kira11-hash/snn-soc/README.md

# SNN SoC 工程

本仓库提供一个**数模混合 SNN SoC**，当前为 MVP 版本，目标迭代到 V1 版本流片（数字单独流片 + 片外混合集成验证），后续再进行片上混合集成。

## 项目目标

| 版本 | 状态 | 说明 |
| :--- | :----: | :--- |
| **MVP** |  ✅ 完成  | 基础功能可仿真跑通 |
| **V1 RTL** | ✅ 功能冻结 | E203 + UART + SPI + DMA多目标 + AXI-Lite bridge + JTAG rescue 全部接入，仿真全量通过 |
| **V1 TO** | 🚧 进行中 | 综合 / PPA / 后端 P&R / DFT / STA 签核 / pad cell 集成 / ROM handoff |

**流片目标**：2026年6月30日，数字 SoC 单独流片 + 片外混合集成验证（数字 SoC + 模拟 CIM Macro）
**时钟频率**：50MHz（目标）

## MVP 功能
- 支持寄存器配置阈值与推理帧数（TIMESTEPS）
- DMA 从 data_sram 搬运 bit-plane 输入到 input_fifo
- CIM 控制器按 帧 × PIXEL_BITS 子时间步循环 DAC/CIM/ADC
- ADC 时分复用 20 路（Scheme B：10 正 + 10 负），`neuron_in_valid` 对应一次完整扫描后的 10 路差分结果
- LIF 在有效拍按 bitplane_shift 左移累加并产生 spike 写入 output_fifo
- Testbench 自动跑完整流程，并按仿真器生成 FSDB 或 VCD 波形

## 快速开始（VCS + Verdi）
> Linux / WSL 原生环境可直接使用 bash。Windows 本机回归建议优先使用 Git Bash；WSL 在本仓库里主要用于 `run_e203_icarus.sh` / `run_jtag_rescue_top_icarus.sh` 的 RISC-V 固件构建链路。

1) 编译并仿真（生成 FSDB）
```
./sim/run_vcs.sh
```

2) 打开 Verdi
```
./sim/run_verdi.sh
```

### 环境变量要求
- `VERDI_HOME`：指向 Verdi 安装目录（用于 FSDB PLI）。
- 若平台版本不同，可在 `sim/run_vcs.sh` 中调整 PLI 路径。
- Windows 下请优先使用 Git for Windows 自带的 `bash.exe` / `sh.exe` 运行 `sim/*.sh`；不要直接用 `C:\Windows\System32\bash.exe`（WSL bash），否则可能找不到本机安装的 `iverilog` / `verilator`。
- 若在 PowerShell 中先执行 `Get-Command bash` 发现命中的是 `C:\Windows\System32\bash.exe`，说明当前 `bash` 实际指向 WSL，而不是 Git Bash；此时普通 Icarus / shell 语法门禁请显式调用 Git Bash（常见路径：`C:\Program Files\Git\bin\bash.exe`），只有 `run_e203_icarus.sh` / `run_jtag_rescue_top_icarus.sh` 这类需要交叉编译固件的脚本才会在内部再转去 WSL。
- 若在 `bash`/WSL 中看到 `$'\r': command not found`，说明本地 checkout 把 `.sh` 脚本变成了 CRLF；仓库期望 `*.sh` 为 LF（见 `.gitattributes`），请先按 LF 重新检出后再运行。
- 带权重的 Icarus/VCS 流程依赖外部生成的 `weight_pos.hex` / `weight_neg.hex`；仓库默认不提交这些导出物，可放在任意 `results/exports/` 目录、`fpga/cim_model/` 或 `sim/` 下；如需显式指定来源，可设置 `WEIGHT_SRC_DIR=<目录>`。
- `run_sample_align.sh` 额外依赖 `all_samples.hex` / `expected_classes.hex`；脚本会在仓库内自动查找 `rtl_stimulus/` 目录，也可通过 `STIMULUS_DIR=<目录>` 强制指定。
- 若在 Windows PowerShell 里直接跑 `chip_top` 门禁，请使用 `iverilog.exe` / `verilator.cmd`；不要把 `iverilog` / `verilator` 包在 `bash -lc "..."` 里，否则可能误走到 WSL 环境中的错误 PATH。
- `run_e203_icarus.sh` / `run_jtag_rescue_top_icarus.sh` 会在运行时临时创建 `rtl/vendor_e203` junction，把仓库内 `e203_hbirdv2-master/rtl` 映射到纯 ASCII 路径后再编译；这是为了规避 Windows + Icarus 对 vendor 路径/非 ASCII 路径的读取问题。脚本退出时会自动清理该 junction，因此不要把 `sim_e203.f` / `sim_jtag_rescue_top.f` 视为完全脱离脚本即可裸跑的 filelist。

## 常用回归入口
> Windows 日常回归建议用 Git Bash；`run_e203_icarus.sh` 额外依赖 WSL 中可用的 `riscv64-unknown-elf-gcc / objcopy`。
> `run_e203_icarus.sh` / `run_jtag_rescue_top_icarus.sh` 会在构建固件时临时覆盖 `UART_BAUD_DIV=2` 以缩短 Icarus 仿真时间；`uart_ctrl` 的默认硬件口径仍是 `434`（50MHz / 115200）。

- `cd sim && bash run_uart_icarus.sh`：UART 单测，期望 `UART_SMOKETEST_PASS`
- `cd sim && bash run_spi_icarus.sh`：SPI 单测，期望 `SPI_SMOKETEST_PASS`
- `cd sim && bash run_dma_icarus.sh`：DMA 单测，期望 `DMA_SMOKETEST_PASS`
- `cd sim && bash run_axi_bridge_icarus.sh`：AXI-Lite bridge 单测，期望 `AXI_BRIDGE_SMOKETEST_PASS`
- `cd sim && bash run_icarus_light.sh`：黑盒顶层 smoke，期望 `LIGHT_SMOKETEST_PASS`
- `cd sim && bash run_icarus_weighted.sh +FAIL_ON_ZERO_SPIKE=1`：带权重顶层回归，期望 `WEIGHTED_SIM_PASS`
- `cd sim && bash run_sample_align.sh`：Python↔RTL 100 样本对齐，期望 `SAMPLE_ALIGN_PASS`
- `cd sim && bash run_adc_sat_counter.sh`：ADC 饱和计数回归，期望 `ADC_SAT_COUNTER_PASS`
- `cd sim && bash run_jtag_loader_icarus.sh`：JTAG rescue loader 单测，期望 `JTAG_MEM_LOADER_PASS`
- `cd sim && bash run_jtag_pyhost_selftest.sh`：Python 主机侧无硬件自测，期望 `JTAG_PYHOST_SELFTEST_PASS`
- `cd sim && bash run_jtag_rescue_top_icarus.sh`：JTAG rescue 顶层回归，期望 `JTAG_RESCUE_TOP_PASS`
- `cd sim && bash run_e203_icarus.sh`：E203 最小启动链回归，期望 `E203_SMOKETEST_PASS`
- `cd sim && bash run_silicon_bringup.sh`：数字 die 自检固件回归，期望 `SILICON_BRINGUP_TB_PASS`
- `cd sim && bash run_prog_bypass_latch.sh`：验证 `PROG_CTRL.START` busy 期间重写不会破坏 in-flight bypass，期望 `PROG_BYPASS_LATCH_TB_PASS`
- `cd sim && bash run_chip_top_rom_smoke.sh`：`chip_top` + `ENABLE_BOOT_ROM=1` + SPI boot smoke，期望 `CHIP_TOP_ROM_SMOKE_PASS`
- `cd sim && iverilog -g2012 -gno-assertions -f rtl_with_chip_top_check.f -s chip_top -o chip_top_check.out`：TO 路径的 `chip_top` 编译门禁
- `verilator.cmd -Wall --lint-only --top-module chip_top -Wno-DECLFILENAME -Wno-UNUSEDSIGNAL -Wno-UNUSEDPARAM -Wno-PINCONNECTEMPTY -Wno-CASEINCOMPLETE -f sim\\rtl_with_chip_top_check.f`：`chip_top` lint 门禁
- `python scripts/check_markdown_links.py`：检查所有 Git 跟踪 `.md` 文件的本地相对链接是否存在

2026-03-31 实跑复核结论：上述 UART/SPI/DMA/AXI-Lite bridge/light smoke/weighted/sample-align/ADC/JTAG loader/JTAG rescue top/E203、`chip_top` 编译/lint、旧 `top_tb` 入口、shell/python 语法门禁，以及 Markdown 本地链接门禁已在当前 `main` 重新执行通过。

完整的 2026-03-31 全量复核覆盖面、通过口径，以及 `chip_top` 编译/lint、旧 `top_tb` 入口和脚本语法门禁说明见 `doc/09_smoke_test_checklist.md`。

## 目录结构
```
rtl/   RTL 实现
  top/      顶层与参数包
  bus/      简化总线与地址译码
  mem/      SRAM + FIFO
  reg/      reg bank + fifo 状态窗
  dma/      DMA 引擎
  snn/      CIM 控制器 + DAC/ADC + LIF + Macro 行为模型
  periph/   UART/SPI 外设 + Rescue JTAG loader

tb/    Testbench
sim/   仿真脚本与波形
scripts/ Python 主机工具
doc/   中文说明文档
```

## V1.1 / Tape-out Prep 增量

- `boot_rom` 已接入主线地址图：
  - `chip_top` 路径下 `BOOT_ROM @ 0x0000_0000..0x0000_0FFF`
  - `INSTR_SRAM @ 0x0000_1000..0x0000_4FFF`
- `fw/boot_rom/boot_rom_main.c`：Mask ROM 里的 SPI bootloader
- `fw/link_app.ld`：应用固件链接到 `0x0000_1000`
- `scripts/make_boot_image.py`：生成带 16-byte `'BOOT'` header 的 SPI flash image
- `tb/chip_top_tb.sv` / `run_chip_top_rom_smoke.sh`：ROM boot 综合级 smoke 已打通
- `fw/silicon_bringup/silicon_bringup.c`：数字 die 自检固件（`test_mode + BYPASS_HANDSHAKE`）

这意味着当前 `main` 已经同时具备：

1. **V1 默认 Gate A 回归口径**（`ENABLE_BOOT_ROM=0`）
2. **Tape-out 目标 boot 口径**（`chip_top.ENABLE_BOOT_ROM=1`）
3. **Day 1 / Day 2 silicon bring-up 基础设施**

## 关键说明
- **参数口径**：所有默认参数与时序常量以 `rtl/top/snn_soc_pkg.sv` 为准，文档中的数值仅作说明与示例，若不一致请以 pkg 为准。
- 当前工程冻结的 RTL / bring-up 参数：`NUM_INPUTS=64`、`ADC_BITS=8`、`PIXEL_BITS=8`、`ADC_CHANNELS=20`、`T=10`、`ratio_code=1`、`THRESHOLD_DEFAULT=2550`、`NEURON_DATA_WIDTH=9`、`reset_mode=soft`，默认离线压缩/预处理口径为 `avgpool8x8`。
- `W=4`（4-bit 量化权重）仅属于 Python 训练/量化实验口径，用于解释建模结果中的权重精度；它**不是** RTL 冻结参数，`rtl/top/snn_soc_pkg.sv` 中无此定义。
- 输入编码：当前默认离线压缩/预处理口径为 `avgpool8x8`，得到 8x8=64 维特征（NUM_INPUTS=64）、每维 8bit；RTL 仅冻结 64x8 接口，不在硬件中固化前处理算法。同一子时间步并行送 64 维特征的第 x 位，顺序为 MSB->LSB。
- data_sram 排布：每个 bit-plane 为 64-bit，按 2 个 32-bit word 保存（word0=低32位，word1=高32位）。
- TIMESTEPS 表示帧数；总子时间步 = TIMESTEPS × PIXEL_BITS。
- 当 TIMESTEPS=0 时，推理立即结束。
- LIF 位宽建议：`LIF_MEM_WIDTH >= NEURON_DATA_WIDTH + PIXEL_BITS`。
- 默认阈值为 `THRESHOLD_DEFAULT`（工程默认计算：`THRESHOLD_RATIO_DEFAULT × (2^PIXEL_BITS - 1) × TIMESTEPS_DEFAULT = 1 × 255 × 10 = 2550`，可软件覆盖）。
- CIM Macro 在仿真中为行为模型，综合时为黑盒，可替换真实宏。
- UART 已实现最小 TX 路径（RX 仍为 V1 预留），SPI 已实现 Mode 0 主控，JTAG 已切换为独立 rescue loader：仅开放 `instr_sram / data_sram / weight_sram` 访问与 CPU 局部重启。
- tapeout 前全量回归的建议检查面与逐项操作说明见 `doc/09_smoke_test_checklist.md`。

## 建模定版补充（复位模式，2026-02-10）
- 对比对象：`SPIKE_RESET_MODE=soft` vs `SPIKE_RESET_MODE=hard`；当前 RTL 默认 `reset_mode=soft`，其余建模参数以各次对比实验冻结配置为准。
- 当前工程默认 `T=10`；如需做精度/时延 trade-off，可额外比较更小的 `T`。
- 对比入口：`run_all.py` 的 `[3f]`（噪声影响，`add_noise=True`）和 `[3l]`（test 多 seed noisy，`add_noise=True`）。
- soft（历史基线）：
  - val noisy mean：`90.41% +/- 0.0031`
  - test noisy（multi-seed）：`90.98% +/- 0.0012`
- hard（2026-02-10 复跑）：
  - val noisy mean：`90.51% +/- 0.0034`
  - test noisy（multi-seed）：`90.98% +/- 0.0012`
- 结论：
  - 当前推荐配置下，soft/hard 在 noisy test 指标上等效（数值一致）。
  - val 侧 `0.10%` 差异小于统计波动量级（`~0.31%-0.34%`），不具显著性。
  - V1 参数继续沿用 `soft`，理由是与既有 RTL/文档口径一致，且无需引入额外改动风险。
- 结果证据：
  - `项目相关文件/器件对齐/Python建模/summary.txt`
  - `项目相关文件/器件对齐/Python建模/results/run_all_skiptrain_hard_20260210_161450.log`

## 文档索引

### 正式文档（推荐阅读）

| 文件 | 内容 |
|---|---|
| `doc/00_overview.md` | 工程总览、当前状态与验证结论 |
| `doc/01_memory_map.md` | 地址映射（SRAM 窗口 + MMIO 分区） |
| `doc/02_reg_map.md` | **寄存器完整说明（权威真源）** |
| `doc/03_cim_if_protocol.md` | CIM 内部接口协议（信号 + 时序） |
| `doc/04_walkthrough.md` | 一次完整推理流程详解 |
| `doc/05_debug_guide.md` | 调试/救援指南（JTAG、常见问题） |
| `doc/06_learning_path.md` | **新手必读学习路径** |
| `doc/07_tapeout_schedule.md` | 流片路线图（主体为历史计划，以文末 Status Sync 为当前状态） |
| `doc/08_cim_analog_interface.md` | 数模接口规格（双芯片 PCB 集成，对外发送权威版本） |
| `doc/09_smoke_test_checklist.md` | **全量仿真操作手册（含命令、预期输出、故障排查）** |
| `doc/10_server_proxy_guide.md` | 校园网服务器代理/VPN 配置 |
| `doc/11_analog_handoff_execution_plan.md` | 数字→模拟接口对接文档（参数已冻结，供模拟团队参考） |
| `doc/12_fpga_validation_guide.md` | FPGA 系统验证指南 |
| `doc/13_fpga_paper_plan.md` | FPGA 验证平台方案 |
| `doc/14_gemm_accelerator_plan.md` | 双模态 AI SoC（GEMM+SNN）扩展规划（V2/V3 远景） |
| `doc/15_asic_pad_map.md` | **ASIC Pad Map（55 pad 冻结真源）** |
| `doc/17_cim_macro_handoff_cover.md` | **发给模拟 CIM macro 同学的封面说明（先读这份）** |
| `doc/16_iteration_log.md` | 迭代变更日志（Phase 4 全外设接入记录） |
<!--
DOC-B3 fix（2026-05-02 audit）：原 4 份 IC 论文 prompt 模板（17/18/19/20）
已从 `eassy-prompt/` 删除（且整目录在 .gitignore 中忽略），保留这 4 行索引
会让读者按图索骥找不到文件。如未来恢复，需要：
  (a) 把 `eassy-prompt/` 从 .gitignore 移出
  (b) 重建这 4 份 prompt 文件
  (c) 重新追加索引
当前 `eassy-prompt/` 仅保留 2 份 GPT review 历史 prompt
（gpt_review_2026-04-22 / gpt_review_2026-04-24），是 audit 工作日志，
不属对外文档索引。
-->

### 草稿文档（已整合到正式文档）
- 早期 `develop docs` 草稿目录已从仓库移除，相关内容已整合到上述 `doc/*.md` 正式文档中；如需追溯演进过程，请查看 Git 历史。

## 片外/片上混合集成说明

本项目将分阶段完成数模集成：
- 数字部分：本项目的 RTL（SoC 控制器、DMA、LIF 神经元等）
- 模拟部分：真实 CIM Macro（由其他同学提供版图）
- V1：数字 SoC 单独流片，片外与模拟宏连接验证
- V2/V3：片上数模混合集成
- 接口约定：`cim_macro_blackbox.sv` 的端口定义保持不变
- 时钟频率：目标 50MHz（数模混合需要保守时序裕量）

### 论文写作口径备忘（V1 vs V2）

- 当前 `V1` 的真实形态是**双芯片 PCB 集成**：数字 SoC 与模拟 `CIM Macro` 独立流片、独立封装，通过 `wl_data / bl_sel / bl_data / cim_start / cim_done` 等 pad 信号互联。
- 当前已经冻结的是**外部推理接口**；若 `V1` 还要求外部模拟 die 支持数字发起 `erase/write/verify`，则仍需先冻结跨芯片编程合同。参见 `doc/17_cim_macro_handoff_cover.md` 与 `doc/11_analog_handoff_execution_plan.md` A8。
- 因此，当前版本**不能**写成“已实现片上数模混合集成”或“已解决互联问题”；更准确的说法是：本工作完成了面向混合集成的数字 SoC，并验证了其与外部 `CIM Macro` 协同工作的控制逻辑、接口协议和推理链路。
- 面向后续 `V2/V3`，可以将“单芯片数模混合集成以降低片间通信延迟、接口能耗与数据搬运开销”写成 roadmap / motivation，但必须明确这是未来工作，而非 `V1` 已实现事实。
- 若后续实现同一颗 die 上的数模混合集成，则可强调“控制器与 `CIM Macro` 的片上紧耦合”带来的系统级收益；若仅做到同封装 `MCM/SiP`，则应表述为“封装级集成”，不等同于单 die 片上集成。

> 推荐备用句式：本工作完成了完整数字 SoC 的设计与 RTL 级验证，并确认了其与外部 `CIM Macro` 协同工作的控制逻辑、接口协议和推理链路；当前 `V1` 采用双芯片 PCB 集成，后续 `V2/V3` 将进一步推进单芯片数模混合集成，以降低片间通信开销并实现更紧耦合的系统级协同。
