kira11-hash/snn-soc/项目相关文件/SNN SoC的读书笔记/ANP-I.md

这篇论文来自**清华大学（陈弘教授团队）**，发表在 **JSSC 2024**（这是集成电路设计领域的顶级期刊）。

它的核心关键词是**“异步逻辑（Asynchronous）”**和**“在线学习”**。虽然你的 V1 版本是同步电路设计，但这篇论文关于**如何通过数字逻辑“偷懒”（跳过无效计算）**的设计思路，对 SoC 性能优化极具参考价值。

---

### 【论文名称】
**ANP-I: A 28-nm 1.5-pJ/SOP Asynchronous Spiking Neural Network Processor Enabling Sub-0.1-µJ/Sample On-Chip Learning for Edge-AI Applications**

**1) SoC 相关核心内容（只写 3–5 条）**
*   **全异步数字架构：** 抛弃了全局时钟，利用“握手协议（Handshake）”驱动数据流。只有在有脉冲时电路才会翻转，没脉冲时完全静默。
*   **随机目标窗口（TW）：** 为了在线学习，不需要存入样本的所有脉冲，而是只抓取一小段“窗口”内的脉冲存入 Buffer。这极大减小了 SoC 内部存储器的面积需求。
*   **分级更新跳过（HUS）：** 在芯片级、内核级、突触级三层设置了“跳过检查”。如果某个区域没有脉冲，直接切断控制路径，不产生访存动作。
*   **异步时间步加速（ATSA）：** 不需要等待固定的时钟周期，一旦当前计算任务完成，硬件立刻“握手”进入下一个时间步，消除了 SoC 的空转等待时间。

**2) 论文里暴露的系统级痛点**
*   **痛点 1：学习能效开销巨大。** 传统 SoC 在做在线学习（BP 算法类似物）时，能耗通常是推理的数倍，导致移动设备无法长时间在线进化。
*   **痛点 2：空闲功耗（Idle Power）。** 在同步 SoC 中，即使没有神经元在发放，时钟网络依然在不断翻转消耗电能。
*   **痛点 3：存储墙问题。** 记录神经元历史脉冲轨迹（用于计算权重更新）需要占用大量片上 SRAM，限制了 SoC 支持的规模。

**3) 可转化为 SoC 数字创新点（3–5 条）**
*   **创新点 1（针对痛点 1 & 3）：脉冲缓冲窗口逻辑（Windowing Buffer）。** 
    *   在 E203 的 DMA 搬运路径上加一个计数器。只在计数器对应的特定区间（窗口）内将计算结果写回 L1 SRAM，其余时间不写。**（✅ 适合 V1：逻辑简单，能省 SRAM 访问能耗）**
*   **创新点 2（针对痛点 2）：层级使能门控（Hierarchical Gating）。** 
    *   设计一个“活动检测器”。当输入脉冲 FIFO 为空时，控制器不仅关闭计算，还通过分级使能信号关闭 CIM Macro 的外围接口电路。**（✅ 适合 V1：作为 SoC 的低功耗卖点）**
*   **创新点 3（针对延迟）：自适应 Done 信号反馈（Non-fixed Timer）。** 
    *   不要用固定的 Counter 来数周期。让 CIM 控制器根据任务量生成一个 `Task_Done` 信号给 E203。E203 收到后立刻切换下一层。这种“准异步”思想能显著提升 SoC 吞吐率。**（✅ 适合 V1：低风险高性能优化）**

**4) 是否适合短期实现（判断）**
*   ✅ **适合 V1（低风险）：** 
    *   **分级跳过逻辑（HUS）的简化版**：检测输入脉冲，为零则不触发 CIM 使能。
    *   **自适应 Done 信号控制流**：这是提高系统效率最快的方法。
*   ⚠️ **适合 V2/V3（高风险）：** 
    *   **全异步逻辑（Self-timed Click Controller）**：异步设计缺乏商业 EDA 工具支持，研一新生 V1 绝对不要碰，风险极高。
    *   **在线学习（S-TP 算法）**：V1 建议专注推理。

**5) 一句总结**
**这篇论文对你的价值在于：它教你如何通过“层层设卡”（HUS 逻辑）和“只管重点”（TW 窗口），在数字层面压榨出极致的稀疏性能效。**

---

### 💡 助手给你的 V1 选点建议：

目前你手里有五篇顶级论文了，如果你要在 **6/30 的 V1 版**中选创新点，我最推荐以下组合：

1.  **分级控制器（来自 SENECA）**：让 E203 当指挥官，自己写个 **Loop Buffer** 跑微指令，这是最稳且最像 SoC 的结构。
2.  **两级断电/使能管理（来自 ISSCC-2023 & ANP-I）**：只要没计算任务，就关掉接口。代码量小，但数据（功耗）对比会非常好看。
3.  **Ping-Pong FIFO 与 Shadow Register（来自 DIANA）**：保证你的 CIM 不要停下来等数据。

**你想针对哪一个创新点的具体 Verilog 实现逻辑进行深入探讨？**

ANP‑I 的核心是**异步逻辑 + 在线学习**，这两点对你 V1（同步、推理为主）**不合适**。  
但它有一些“思想层”的点可以借鉴成**同步系统里的轻量优化**：

**✅ V1 可以借鉴的（同步可做）**

1. **活动检测 + 计算跳过**
    
    - 当输入 FIFO 为空、或某个 bit‑plane 全 0 时，**不触发 CIM/ADC/LIF**。
    - 这其实是“同步版 HUS（跳过无效计算）”。
2. **层级使能门控（简化版）**
    
    - 不是异步电路，只是同步下的 enable/clock-enable。
    - 空闲时关闭 CIM/ADC/LIF 的时钟或使能，节能好讲故事。
3. **任务完成即 done（自适应 done）**
    
    - 不固定数周期，而是“任务跑完就 done”，你现在 FSM 基本就是这个思路。

**❌ V1 不建议碰**

- **全异步握手机制（handshake / self‑timed）**
- **在线学习/窗口记录机制**

**一句话结论**  
ANP‑I 适合当“论文动机来源”，V1 只吸收“跳过无效计算 + 空闲门控”这种轻量思想，**不要做异步逻辑**。

如果你要选一个 V1 落地的点，我建议：  
**“输入活动检测 → 自动跳过 CIM/ADC 并拉低 enable”**  
这块最稳、成本低，还能作为功耗亮点写进论文。
