kira11-hash/snn-soc/项目相关文件/SNN SoC的读书笔记/DIANA An End-to-End Hybrid DIgital and ANAlog Neural Network SoC for the Edge.md

这篇论文是来自 **KU Leuven（鲁汶大学）** 团队在 JSSC 2023 上发表的 **DIANA**。它是数模混合 SoC 的标杆作品，非常适合你用来构思 V1 版本的系统架构，因为它清晰地展示了如何用一个 RISC-V 控制一个“模拟黑盒”和一个“数字黑盒”。

【论文名称】
**DIANA: An End-to-End Hybrid DIgital and ANAlog Neural Network SoC for the Edge**

### 1) SoC 相关核心内容（只写 3–5 条）
*   **异构多核架构：** 整个 SoC 由一个 RISC-V 核心（PULPissimo 架构）、一个模拟 CIM 加速器（AIMC）和一个数字加速器（Digital Core）组成。
*   **三级存储体系：** 采用 L2 (512KB) -> L1 (256KB) -> L0 (寄存器) 的层次。L1 SRAM 被模拟和数字两个内核共享，作为它们之间的数据交换站（Communication Buffer）。
*   **专用存储控制器（MCU）：** 为 CIM 宏设计了专门的地址产生逻辑（Address Generator），支持卷积的滑动窗口、步长（Stride）和填充（Padding），不需要 CPU 干预地址计算。
*   **后处理流水线（SIMD）：** 在 CIM 宏的 ADC 输出后，紧跟了一个数字 SIMD 单元，专门负责 BatchNorm、ReLU、池化和量化，将模拟结果转回数字脉冲/数据。

### 2) 论文里暴露的系统级痛点
*   **痛点 1：权重搬运瓶颈。** 模拟 CIM 阵列虽然算得快，但“写权重”极慢。当网络层数很多且阵列放不下所有权重时，频繁从片外加载权重会导致计算单元严重空转。
*   **痛点 2：数据格式不匹配（Layout Mismatch）。** 模拟核喜欢按通道（Channel）并行，数字核喜欢按输出像素（OX）并行，导致数据在两个核之间传递时，必须进行耗时的“数据重组（Reshuffling）”。
*   **痛点 3：L1 缓存管理复杂。** 256KB 的 L1 需要被 CPU、DMA、模拟核、数字核四个角色同时竞争访问，如果仲裁（Arbitration）逻辑设计不好，会造成严重的流水线气泡。

### 3) 可转化为 SoC 数字创新点（3–5 条）
*   **创新点 1（针对痛点 3）：多行/多银行共享 L1 SRAM 仲裁器。** 设计一个支持高带宽、多端口的 L1 控制器，让 E203 在读取指令的同时，DMA 能够无冲突地把数据喂给 CIM Macro。**（V1 推荐：提升系统稳定性）**
*   **创新点 2（针对痛点 2）：硬件重组 DMA（Reshuffling DMA）。** 在 DMA 搬运过程中增加一个简单的硬件转置逻辑，数据从 CIM 出来进入 L1 时自动完成格式转换，消灭 CPU 整理数据的时间。**（V2 推荐：体现系统效率）**
*   **创新点 3（针对痛点 1）：预取控制器（Prefetching Controller）。** 利用影子寄存器，在 CIM 计算当前层时，控制器自动计算并触发 DMA 从 L2 提取下一层的权重到缓存。**（V1/V2 推荐：解释性强）**
*   **创新点 4（系统级）：端到端流水线（Layer Fusion）。** 设计硬件同步信号（Done/TRG 手柄），实现“层融合”：模拟核算完一小块数据，立刻触发数字核进行激活，不需要 CPU 频繁中断。

### 4) 是否适合短期实现（判断）
*   ✅ **适合 V1（低风险）：** 
    *   **L1 共享机制：** 用总线矩阵把 E203 和 CIM 连接到同一块 SRAM。
    *   **基础 FSM 控制器：** 代替 CPU 发送控制信号（如 `start_compute`, `read_adc`）。
*   ⚠️ **适合 V2/V3（高风险）：** 
    *   **硬件重组逻辑：** 涉及复杂的地址映射切换。
    *   **多核并行流水线：** 调试难度大，容易产生死锁（Deadlock）。

### 5) 一句总结
**DIANA 告诉我们：SoC 设计的关键不在于 CIM 阵列怎么画，而在于如何通过“多级缓存”和“硬件 FSM”让 CIM 阵列永远有数可算，不让 CPU 成为指挥瓶颈。**
✅ **V1 不需要再从 DIANA 加新功能**  
✅ 你最多只需要“借鉴它的理念作为论文对比点”
