kira11-hash/snn-soc/项目相关文件/SNN SoC的读书笔记/rram-sram-hybrid-target-tracking.md

这篇论文来自 **Georgia Tech（佐治亚理工）Arijit Raychowdhury** 教授团队，发表于 **ISSCC 2023**。它是一个非常典型的“数模混合异构系统”，最值得你借鉴的是它如何处理**“不稳定的 SNN 输出”**以及如何**“管理一个平时休眠、偶尔唤醒的大功耗 Macro”**。

【论文名称】
**A 73.53TOPS/W 14.74TOPS Heterogeneous RRAM In-Memory and SRAM Near-Memory SoC for Hybrid Frame and Event-Based Target Tracking**

### 1) SoC 相关核心内容（只写 3–5 条）
*   **异构双流水线：** SoC 包含一个 SRAM-based SNN 模块（处理 DVS 事件流，实时性强但精度低）和一个 RRAM-based CNN 模块（用于高精度校准）。
*   **中央协调控制器：** 使用 ARM Cortex-M3 作为主控，通过 AHB-Lite 总线管理 RRAM-CIM 和 SRAM-SNN 两个加速器。
*   **硬件触发机制：** 系统不是一直运行 CNN。SNN 持续工作，当数字逻辑检测到 SNN 输出的“时空连续性”变差时，自动发送硬件信号唤醒 CNN 进行补救。
*   **两级电源门控（Power Gating）：** 数字系统可以对 CIM Macro 进行模块级（Module）和宏级（Macro）的两级断电管理，实现 91.8% 的功耗节省。

### 2) 论文里暴露的系统级痛点
*   **痛点 1：输出质量不可靠。** 模拟计算和 SNN 的特性导致其输出波动大。如果直接拿这个结果去执行动作（如无人机转向），系统会崩溃。
*   **痛点 2：静态功耗巨大。** CIM Macro 如果一直通电，哪怕不计算，漏电流功耗也会榨干电池（占据系统主要功耗）。
*   **痛点 3：CIM 的高误码率（BER）。** 论文提到 RRAM CIM 在没有纠错（ECC）时，精度下降高达 40.6%，必须在数字后端进行强力干预。

### 3) 可转化为 SoC 数字创新点（3–5 条）
*   **创新点 1（针对痛点 1）：时空连续性监控逻辑（Spatio-temporal Continuity Monitor）。** 
    *   在数字端设计一个滑动窗口统计模块，实时计算 SNN 输出脉冲的分布规律。如果分布太散乱，立即触发信号。**（⚠️ 适合 V2/V3：涉及算法策略）**
*   **创新点 2（针对痛点 2）：两级 FSM 电源调度器。** 
    *   在控制器中实现一套复杂的电源状态机。不仅能关掉计算模块，还能根据任务需求只开启一部分阵列，由逻辑自动控制 Power Switches。**（✅ 适合 V1：纯数字逻辑实现，性价比高）**
*   **创新点 3（针对痛点 3）：三级纠错（TEC）逻辑。** 
    *   在 CIM 读出接口增加强力纠错电路（如 DEC 或 TEC），虽然增加了延迟，但能保证数据流入下一层前是正确的。**（⚠️ 适合 V2：代码量大，验证复杂）**
*   **创新点 4（针对数据搬运）：FIFO 缓冲事件分发器。** 
    *   针对 11Mevents/s 的高带宽需求，设计一个多级 FIFO 缓冲系统，防止计算端（CIM）在峰值流量时因来不及处理而丢失脉冲。**（✅ 适合 V1：保证系统稳定性必做）**

### 4) 是否适合短期实现（判断）
*   ✅ **适合 V1（低风险）：** 
    *   **两级电源门控控制逻辑：** 这种“省电”逻辑在流片时非常好讲故事。
    *   **事件 FIFO 缓冲池：** 保证数字 SoC 的吞吐率不掉链子。
*   ⚠️ **适合 V2/V3（高风险）：** 
    *   **三级纠错（TEC）：** 这对数字逻辑的面积和时序挑战很大。
    *   **跨内核唤醒触发逻辑：** 需要 SNN 和 CNN 两套系统联调，风险极高。

### 5) 一句总结
**这篇论文的价值在于：它提供了一套“SNN 快速响应、CNN 慢速校准”的异构调度方案，并展示了数字系统如何通过“分级断电”和“硬件纠错”来伺候一个不完美的存储计算内核。**

## 可以借鉴（但只做“轻量版本”）

### 1) 低功耗管理思想（✅ 有价值，但 V1 只能做“软版”）

- **论文里的做法**：两级 power gating（模块级/宏级断电）。
- **你能做的 V1 版本**：
    - **数字侧：做“空闲检测 + clock gating/enable gating”**
    - **接口侧：预留 power_state/enable pin 和握手时序**（留给 V2 真正做电源门控）。
- **为什么有价值**：可以在论文里说“为未来与 RRAM 混合集成预留功耗管理框架”。

### 2) 可靠性/异常检测（✅ 轻量版可做）

- 论文中的“输出不稳定”问题真实存在，但你 V1 没有真实 RRAM，所以**不能做“真纠错”**。
- 你可以做**很轻的“异常监测”**，例如：
    - ADC 输出**是否饱和/是否长期不变**
    - LIF 输出**是否全零/全一**
    - 统计**方差、峰值**作为“可信度指示”
- 作用：**不是修正结果，而是给 CPU/日志一个“置信度标志”**。

### 3) FIFO/缓冲策略（✅ 你已经有）

- 论文用 FIFO 抗峰值事件流。
- 你现在是时间步系统，但**输入 FIFO/输出 FIFO 已经具备类似意义**。
- 所以它的价值在于**给你已有设计提供文献支撑**。

---

## 不适合 V1 的部分（只写到未来路线）

- **SNN 输出异常触发 CNN 校正**：你没有 CNN 核，且 V1 不需要。
- **强纠错 (ECC/TEC)**：对数字逻辑复杂、验证成本大，不适合 V1。
- **事件驱动多核调度**：架构不一致。

---

## 一句话结论（给你写论文/开题用）

> 这篇论文的最大启发在于“系统层的功耗调度与可靠性保障”。对我 V1 而言，它主要作为**设计动机与未来路线图的参考**，而非直接落地实现。
