kira11-hash/snn-soc/项目相关文件/器件对齐/对齐会议材料.pptx

## 对齐会议

2026.2.5
陈庆安

## 0. 一句话说明：我们要做什么 我们要做一个 SNN SoC（基于脉冲神经网络算法的系统芯片），其中 模拟 CIM Macro（采用氧化物RRAM 阵列 ） 作为 SoC 里的一个加速 IP，负责神经网络里的乘加运算。 数字 SoC 负责 数据搬运、时序控制、量化接口、神经元累加与阈值发放（spike），并与模拟宏进行片外/片上系统级协同验证。

## Slide 3

数字电路---把CIM MACRO当IP
做成一个能够执行推理的完整加速器系统

模拟电路---存算一体macro

器件阵列

数据流（固定通道）：data_sram → DMA → input_fifo → CIM →lif_neurons →output_fifo
控制流（可编程）：CPU 仅做 配置/启动/读取结果；核心推理不靠 CPU 一拍一拍参与

外部输入
Flash --SPI--> CPU--写--> data_sram
| 配寄存器/启动/读结果
v
DMA 引擎 ---> input_fifo ---> DAC/CIM/ADC 控制链 ---> LIF ---> output_fifo
外部输出
CPU --UART--> PC（打印日志/传输结果）

## Slide 4

1. 三方分工与边界（器件/模拟/数字）
2.1 器件侧
- RRAM 单元与阵列实现、后道工艺集成
- 提供 可量化的数据：电导范围/级数/分布、噪声、漂移、写读条件等
2.2 模拟侧
- DAC/ADC、MUX、偏置/参考、读写脉冲整形等外围电路
- 给出 接口电气/时序约束（例如：读出建立时间、ADC 采样时间、输出范围等）
2.3 数字侧
- SoC 控制与数据通路及完整架构的设计：DMA / FIFO / 控制器 / LIF 神经元 / 寄存器映射 等
- 与模拟宏的数字接口协议定义与实现（握手、通道选择、数据采样时序）
- Python 端到端建模（含量化/噪声）→ 反推 ADC 位数、阈值、数据搬运策略等设计决策

## Slide 5

2. V1 → V2 → V3 迭代计划
V1（2026/06/30）：数字与模拟部分单独流片（风险最低，先保证“系统跑通”），后道集成 RRAM
数字与模拟分别验证成功后：片外数模混合集成（系统级对齐）
- 两颗芯片分别上板（各自 PCB），通过排针/连接器做片外互联
- 在同一时钟/复位下跑通端到端推理流程
V2&V3：数字侧加入“强依赖器件特性”的机制（在器件数据稳定后再做）/片上数模混合集成（最高风险、最高系统完整度）
支线合作方向：把氧化物 RRAM 阵列做成可用的存储器宏
氧化物 RRAM 在 binary情况下性能极好，为 RRAM 阵列设计 数字外围电路，把它封装成一个可集成进 SoC 的存储器宏，提供清晰、稳定、可验证的存储器接口与时序。

## Slide 6

3. 一次推理是怎么跑的（从上电到输出）
3.1 输入编码
- MNIST 28×28 灰度图（8-bit）→ 软件降采样为 7×7（49 像素）
- 每个像素 8-bit → bit-plane：把一张图拆成 8 个子时间步（MSB→LSB）
- 同一子时间步内：并行送入 49 个像素的第 x 位（49 路 0/1）
3.2 关键循环（每帧 8 个子时间步）
对每一帧（TIMESTEPS 次，可重复同一张图以积累膜电位）：
1. DMA 把一个 bit-plane（49-bit）送入 input_fifo
2. 控制器取出 bit-plane → DAC 握手锁存
3. 触发 CIM 计算 ，等待 cim_done
4. ADC 时分复用 10 路输出：
5. LIF先进行权重累加：超过阈值则产生 spike 写入 output_fifo
6. 一帧 8 个 bit-plane 完成后进入下一帧；所有帧完成后 done
3.3 为什么会有 TIMESTEPS（帧数）
很多情况下需要 跨多个时间步积累才容易超过阈值形成稳定 spike。
TIMESTEPS 可用来做性能/能耗/准确率权衡，也方便实验复现。

## Slide 7

6. 当前工程做到什么程度了
6.1 已实现（仿真验证已经跑通 ）
- 总线/寄存器映射（simple bus）
- instr/data/weight SRAM
- DMA（固定路径：data_sram → input_fifo）
- input_fifo / output_fifo（速率解耦与事件缓冲）
- SNN 控制链：DAC_CTRL / CIM_CTRL / ADC_CTRL（含 10 路时分复用）
- LIF 神经元：按 bitplane_shift 移位累加 + 阈值比较 + spike 输出
- CIM Macro：仿真用行为模型（可复现输出），综合时为黑盒（替换真实宏）
6.2 未实现/占位（完整版要补）
- UART/SPI/JTAG：目前是 stub（占位，不做真实协议）
- CPU+ AXI-Lite 总线：规划中，后续接入以支持固件/外部 Flash 启动

## Slide 8

7、需要收集哪些器件信息？

优先级 | 需要拿到的信息 | 用于什么
🔴 🔴 🔴 | 电导值范围与级数（conductance range + levels，含分布/方差） | 权重量化映射、输出动态范围、ADC 位数初值
🔴 🔴 🔴 | 是否支持写权重 + 写入接口要求（脉冲类型/幅度/宽度/次数/是否需要 verify） | 决定是否做 Program-and-Verify、是否需要写入通路/寄存器/DMA 扩展
🔴 🔴 | 读噪声特性（RMS/峰峰值、随温度/时间变化、与读电压关系） | Python 建模中 ADC 误差/ENOB 估算、容错策略
🔴 | 温漂、保持、耐写次数 | V2/V3 可靠性与校准策略（现在知道越早越好，不急）

额外补充：
- 权重“正负号”怎么支持？
训练得到的权重通常有正负；需要确认：差分阵列/双阵列相减/2T2R/offset mapping 哪一种可行。
这会直接影响 ADC 量化范围（单极/双极）与系统精度。
- 读出电压/电流范围（ADC 前端输入范围 & 饱和点）
用于把“电导/电流”换算到“ADC code”的动态范围。
- 读出延迟/建立时间
用于定系统时序参数（DAC/CIM/ADC latency），决定控制器节拍与吞吐。

## Slide 9

8. 交付的形式（建模用）
1) 电导级数据表）
- level index → 典型值（mean）→ 方差/分布（std 或直方图）
- 若有器件间/周期间差异，也建议分别给出
2) 读噪声模型
- 噪声的量纲（电导/电流/电压/ADC code）与随条件变化关系
3) 写入条件与可编程性
- 写脉冲（幅度/宽度/次数/极性/是否需要 forming）
- Program-and-Verify 是否必要、verify 的判据（误差容忍）
4) 阵列/单元结构信息
- 是否差分（正负权重）
- 阵列可行规模与主要限制因素（IR drop、串扰、sneak path 等）
> 有条件的话：给一个“可简化的行为级模型”（哪怕只是一套经验公式），系统端会非常好用。

## Slide 10

9. 我拿到器件信息后会做什么（Python 建模 → 设计决策）
我会建立一个与硬件链路一致的端到端仿真：
1) 软件预处理：MNIST 28×28 → 7×7（选择最合适降采样方式）
2) 训练/量化：训练得到 W，再映射到器件可用的 conductance levels
3) 加入器件噪声/漂移模型 + ADC 量化模型
4) 扫描参数并输出曲线：
- ADC bits（8/10/12/14…） vs 准确率
- 量化位宽（权重 bit） vs 准确率
- 噪声强度 vs 准确率
5) 形成系统级设计决策：
- ADC 位数（满足算法精度的最低位数 + 裕量）
- 阈值/膜电位位宽（保证不溢出且利于稳定发放）
- 是否需要 Program-and-Verify / Reference Column / 校准周期
- DMA/Buffer 是否要扩展（例如写权重/搬运结果/减少 CPU 参与）

## Slide 11

谢谢大家！
