kira11-hash/snn-soc/项目相关文件/SNN SoC的读书笔记/C-DNN.md

这篇论文来自 **KAIST（韩国科学技术院）** 团队，发表于 **JSSC 2024**。它最大的核心思想是**“互补”**：CNN 擅长处理高亮度/密集数据，SNN 擅长处理低亮度/稀疏数据。

虽然你只做一个 SNN SoC，但它在**数据调度、权重复用和稀疏性优化**上的数字逻辑设计非常值得借鉴。

---

### 【论文名称】
**C-DNN: An Energy-Efficient Complementary Deep-Neural-Network Processor With Heterogeneous CNN/SNN Core Architecture**

**1) SoC 相关核心内容（只写 3–5 条）**
*   **任务分配器（Workload Allocator）：** 在硬件层实时统计输入数据的稀疏度（Spike Sparsity），动态决定这一层该用哪个核跑，或者决定哪些 Tile 需要跳过。
*   **注意力模块（Attention Module）：** 一个专用的数字小模块，通过池化和简单卷积生成“注意力图”，提前过滤掉图像中不重要的区域，从而大幅增加 SNN 处理时的脉冲稀疏度。
*   **分布式 L1 缓存（Distributed L1 Cache）：** 在每个 PE（计算单元）内部加了一个 9×4-bit 的寄存器堆，专门用来暂存当前卷积窗口的权重。
*   **两步脉冲编码（Two-step Encoding）：** 放弃了传统的复杂计数器，改用“全局计数器+局部随机偏移”的逻辑，降低了 SNN 时间窗口管理的开销。

**2) 论文里暴露的系统级痛点**
*   **痛点 1：重复访存能耗。** 在 SNN 计算中，同一个卷积窗口的权重在多个时间步（Time-steps）内会被反复使用。如果不加缓存，频繁读取 L2 SRAM 会消耗 70% 的推理功耗。
*   **痛点 2：SNN 对密集数据无力。** 当输入图像非常复杂、脉冲非常多时，SNN 的加法次数激增，能效反而不如传统 CNN。
*   **痛点 3：训练/反向传播开销。** 传统的 SNN 在线学习需要记录脉冲发生的精确时间（Timer），这需要海量的计数器，面积开销极大。

**3) 可转化为 SoC 数字创新点（3–5 条）**
*   **创新点 1（针对痛点 1）：基于寄存器的“突触预加载”缓冲逻辑。** 
    *   在 CIM Macro 的输入端设计一个微型寄存器组（L1 Cache）。利用 SNN 的时间特性，将一次读取的权重锁存，供后续 N 个时间步复用。**（✅ 适合 V1：显著降低功耗，逻辑闭环清晰）**
*   **创新点 2（针对痛点 2）：硬件稀疏度统计模块（Sparsity Monitor）。**
    *   在 DMA 搬运数据时，增加一个简单的硬件计数器，统计非零值的比例。如果稀疏度低于阈值，直接触发报警或由 E203 采取降频措施。**（✅ 适合 V1：低风险的系统级监控）**
*   **创新点 3（针对系统能效）：动态阈值/注意力过滤网（Spike Filter）。**
    *   在数据进入 CIM Macro 前，增加一个可配置的数字比较器。如果某个像素值过低，硬件自动将其归零（强制稀疏化），人为制造稀疏性以节省 CIM 翻转能耗。**（⚠️ 适合 V2：需要算法协同验证）**

**4) 是否适合短期实现（判断）**
*   ✅ **适合 V1（低风险）：** 
    *   **PE 内权重寄存器（L1 Cache）：** 这种“以面积换功耗”的思路非常适合作为 V1 的数字亮点。
    *   **全局计数器逻辑：** 替代复杂的每神经元计时器，简化控制路径。
*   ⚠️ **适合 V2/V3（高风险）：**
    *   **Attention Module：** 涉及额外的计算逻辑，V1 没必要引入新的计算负担。
    *   **FDWSG（训练加速）：** V1 建议只做推理，不碰训练。

**5) 一句总结**
**C-DNN 告诉我们：通过在数字前端增加“稀疏性过滤（Attention）”和在 PE 内部增加“权重寄存器复用”，可以把原本高功耗的计算任务变得极其“省电”。**

- **C‑DNN 不是你的直接模板**，因为它是 **CNN+SNN 双核**、还有 Attention 模块，与你的 V1 架构不匹配。
- 但它在**“稀疏性监测 + 权重复用减少访存”**这两条上，对你有价值（主要是**系统级能耗动机**）。

---

## ✅ 有参考价值（写进论文动机 & 可做 V2）

1. **稀疏性统计 / 监控**
    
    - 这点与你的 SoC 完全兼容：你可以在 DMA/输入 FIFO 旁做一个**“非零计数器”**。
    - 用来做：
        - 统计输入是否稀疏
        - 作为能耗监控的量化指标
    - **V1 可做（很轻）**，但“真正用于控制策略”要到 V2 才有意义。
2. **减少 SRAM 反复读写（权重复用）**
    
    - C‑DNN 用寄存器缓存权重窗口，节省 SRAM 能耗。
    - 你的 CIM 权重主要在宏里，不是 SRAM 重复读取，所以**直接对应性弱**。
    - 但你可以迁移为：  
        **“神经元状态/阈值等小量参数做寄存器缓存”**，减少频繁 SRAM 访问。
    - **V2 可做**，V1 可以只写“启发来源”。

---

## ⚠️ 不适合 V1 的

1. **Attention 模块 / 额外 CNN 计算**
    - 这是“另一个计算核”，与你 SNN+CIM 的目标不一致。
2. **双核协作策略**
    - 你只有 SNN 核，没有 CNN 核，借鉴意义仅限于“对比背景”。
3. **训练相关逻辑**
    - V1 只做推理，训练全部跳过。

---

## ✅ 你现在最合理的“吸收方式”

把 C‑DNN 写成一句动机：

> “C‑DNN 提示：SNN 的系统能耗瓶颈往往在数据搬运和无效计算，因此本 SoC 在输入路径上提供稀疏度统计能力，并规划在后续版本加入更精细的低功耗数据调度机制。”

这样能**借到思想**，但不背设计负担。

---

## 如果你想把它变成 V1 的一个“亮点”（轻量且安全）

- 加一个**输入稀疏度计数器（Sparsity Counter）**：
    - 在 DMA/输入 FIFO 旁，统计一帧内 non‑zero 数量
    - 把数值放在一个只读寄存器里
    - 论文里可写“系统级稀疏性监控”

这个成本极低，工程风险很小，而且能写进论文。
