kira11-hash/snn-soc/项目相关文件/SNN SoC的读书笔记/ODIN.md

这篇论文介绍的是 **ODIN**，来自比利时鲁汶大学（UCLouvain）团队。它是数字 SNN 处理器中的经典之作，核心贡献在于通过**时间复用（Time-multiplexing）**极大地压缩了芯片面积，并实现了**在线学习**。

对于你做 SoC 系统设计，ODIN 提供了非常清晰的“控制器驱动计算核心”的参考模型。

---

### 【论文名称】
**ODIN: A 0.086-mm² 12.7-pJ/SOP 64k-Synapse 256-Neuron Online-Learning Digital Spiking Neuromorphic Processor in 28nm CMOS**

**1) SoC 相关核心内容**
*   **时间复用架构（Time-multiplexing）：** 物理上只有一个计算核心，通过快速轮询 SRAM 里的数据，模拟出 256 个神经元和 64k 个突触。
*   **统一存储映射：** 神经元状态（膜电位）和突触权重分别存储在独立的 SRAM 块中，由中央控制器统一调度。
*   **扩展 AER 接口：** 采用了工业界标准的 AER（地址事件表示）接口，但进行了扩展，通过不同的地址编码来区分“神经元脉冲”、“突触更新”和“配置参数”。
*   **事件触发控制流：** 整个 SoC 不是按时钟周期死板运行，而是“没脉冲就休眠”，通过输入 FIFO 里的脉冲事件来唤醒 FSM（有限状态机）。

**2) 论文里暴露的系统级痛点**
*   **痛点 1：串行化导致的延迟瓶颈。** 因为是时间复用，处理一个脉冲需要 512 个时钟周期。当网络变大时，实时性会迅速变差。
*   **痛点 2：SRAM 面积与功耗占大头。** 论文显示 SRAM 占了 65% 的面积。在低频（生物时间尺度）运行时，SRAM 的漏电流（Leakage）是主要的功耗来源。
*   **痛点 3：控制器状态机极其复杂。** 核心控制器需要处理 5 种不同的事件类型和复杂的在线学习算法（SDSP），这会增加数字设计的验证难度。

**3) 可转化为 SoC 数字创新点**
*   **创新点 1（针对痛点 1）：可配置时间复用深度。**
    *   设计一个可编程的控制器，允许根据任务规模动态调整逻辑神经元的数量（例如：小网络用 64 神经元以换取低延迟，大网络用 256 神经元）。**（✅ 适合 V1：灵活性亮点）**
*   **创新点 2（针对痛点 2）：低功耗 SRAM 管理逻辑。**
    *   在数字系统层面引入“分行控制”或“自动睡眠”逻辑。当 FSM 确定接下来的 N 个周期不访问某块 SRAM 时，自动拉低其使能信号。**（✅ 适合 V1：易于实现的节能方案）**
*   **创新点 3（针对痛点 3）：AER 包解复用器（De-muxer）。**
    *   在 SoC 输入端做一个硬件包解析器，将复杂的扩展 AER 地址直接预译码成简单的控制信号（Start_Update, Weight_Read 等），减小中央 FSM 的设计压力。**（✅ 适合 V1：模块化设计）**
*   **创新点 4（系统级演进）：在线权重重写控制器。**
    *   利用 SoC 的 DMA，在 CIM 计算间隙，按照学习算法（如 SDSP）自动计算新权重并回写进存储。**（⚠️ 适合 V2/V3：涉及复杂的数模协作）**

**4) 是否适合短期实现（判断）**
*   ✅ **适合 V1（低风险）：** 
    *   **时间复用逻辑：** 虽然 ODIN 是纯数字，但这种“轮询 SRAM 数据给 MAC 计算”的逻辑，完全可以移植到你的“轮询 SRAM 数据给 CIM Macro 计算”中。
    *   **标准 AER 接口模块：** 这是 SNN SoC 通信的门面。
*   ⚠️ **适合 V2/V3（高风险）：** 
    *   **在线学习（SDSP）：** 逻辑非常复杂，初次流片建议先做推理（Inference）。

**5) 一句总结**
**ODIN 告诉我们：即使硬件资源（CIM Macro）有限，通过设计一套精巧的“时间复用 FSM”，也能让单块芯片跑起成千上万个神经元的网络。**

**哪些“适合借鉴（主要是写进动机/对比）”**

- **时间复用思想**：这点对你有价值，但它本质是“控制策略”，不一定要改硬件。你可以在论文里写：本 SoC 采用分批/分组调度方式，让单个 CIM 处理多个逻辑神经元组，达到时间复用的效果。
- **控制器驱动核心**：ODIN 的核心不是“CPU 算”，而是“控制器调度”。你现在的 FSM + DMA 路线，已经体现了这一点。

**哪些“目前不适合”**

- **AER 事件接口**：你是“时间步同步”模式，不是事件驱动，AER 不仅没必要，还会扰乱你现有架构。
- **在线学习（SDSP）**：V1 明显太复杂，且和你重点（推理+SoC稳定）不匹配。
- **复杂的事件解复用器**：这只有在“事件流输入”模式才有价值。

**哪些“可以作为 V2 备选方向”**

- **低功耗 SRAM 管理**：如果你后续加大 SRAM 规模，可以考虑分银行/按需时钟门控。
- **可配置时间复用深度**：如果你开始做“同一 CIM 轮询更多逻辑神经元”，可以做简单的可配置参数。
