kira11-hash/snn-soc/项目相关文件/SNN SoC的读书笔记/seneca-digital-neuromorphic.md

这篇论文来自 **IMEC** 团队，介绍的是 **SENECA** 架构。与上一篇 DIANA 不同，SENECA 是**纯数字**神经形态处理器。它最大的价值在于提出了**“分级控制”**的概念，非常适合你用来优化 E203 与加速器之间的指令负载分配。

【论文名称】
**SENECA: building a fully digital neuromorphic processor, design trade-offs and challenges**

### 1) SoC 相关核心内容（只写 3–5 条）
*   **双层分级控制器：** 系统包含一个灵活控制器（RISC-V Ibex）和一个专用优化控制器（Loop Buffer）。RISC-V 处理复杂的任务流（如地址转换），Loop Buffer 负责高频、重复的底层微代码执行。
*   **SIMD NPE 阵列：** 包含 8 个神经元处理元件（NPE），采用单指令多数据（SIMD）架构并行更新神经元状态。
*   **寄存器级数据重用：** 每个 NPE 内部有独立的微型寄存器文件（Register File），用于暂存神经元模型参数（如膜电位），避免频繁读写 SRAM。
*   **轻量化 NoC：** 支持硬件级多播（Multicasting）和脉冲压缩（Spike Compression），专门优化 SNN 稀疏脉冲的传输。

### 2) 论文里暴露的系统级痛点
*   **痛点 1：控制器的“指令开销”巨大。** 实验发现 RISC-V 如果直接执行“每突触（per-synapse）”操作，能耗比加速器高 10 倍以上。CPU 必须从高频循环中解脱出来。
*   **痛点 2：时钟树功耗占比高。** 如图 3 所示，时钟树（Clock Tree）消耗了约 22% 的能效，在稀疏计算中，无效翻转是巨大的浪费。
*   **痛点 3：存储器访问功耗占大头。** 访存能耗（SRAM）占总能耗的 43%，如果直接从 SRAM 读写每个神经元状态，系统能效无法提升。

### 3) 可转化为 SoC 数字创新点（3–5 条）
*   **创新点 1（针对痛点 1）：微指令循环缓冲区（Loop Buffer）。** 
    *   在 E203 和 CIM 控制器之间加一个极小的 SRAM/寄存器组（存储 16-64 条指令）。E203 只需下达一次“开始”指令，底层逻辑自动循环跑完。**（V1 强烈推荐：实现简单且显著提升性能）**
*   **创新点 2（针对痛点 3）：寄存器级状态缓存。**
    *   在数字控制器里设计一个局部 Cache，专门暂存当前正被 CIM 宏操作的那个 Channel 的神经元状态。论文数据证明：利用寄存器代替 SRAM 访存，能效可提升约 20 倍。**（V1 推荐：低风险）**
*   **创新点 3（针对 SNN 特性）：脉冲分组处理逻辑（Spike Grouping）。**
    *   设计一个硬件 Buffer 收集一段时间内的脉冲，将针对同一个神经元的多次脉冲合并成一次“状态更新”，减少对 CIM/SRAM 的操作频率。**（V2 推荐：中等难度）**
*   **创新点 4（针对痛点 2）：事件触发型时钟门控（Event-driven Clock Gating）。**
    *   不是由软件控制开关，而是由硬件检测任务 FIFO 是否为空，自动关掉整个 CIM 控制接口的时钟翻转。**（V1 推荐：作为低功耗亮点）**

### 4) 是否适合短期实现（判断）
*   ✅ **适合 V1（低风险）：** 
    *   **Loop Buffer：** 只需要写一段简单的 FSM 和几组配置寄存器。
    *   **NPE 内部寄存器：** 本质上是给 CIM 控制逻辑加一些临时变量暂存区。
*   ⚠️ **适合 V2/V3（高风险）：**
    *   **Spike Compression/Multicasting：** 涉及 NoC 协议修改，V1 没必要动总线。

### 5) 一句总结
**SENECA 的价值在于：它证明了“CPU 只管发号施令，底层加个 Loop Buffer 跑微代码”是数字 SoC 兼顾灵活性和能效的最优解。**
