kira11-hash/snn-soc/项目相关文件/SNN SoC的读书笔记/Pasted image 20260130172125.png

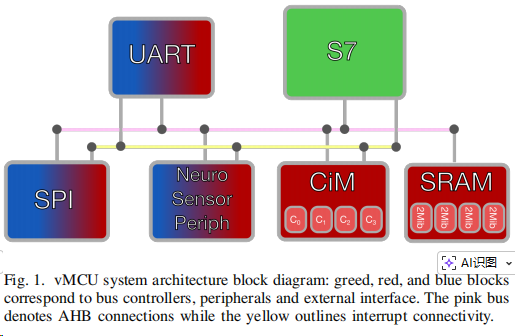
项目相关文件/SNN SoC的读书笔记/Pasted image 20260130172125.png
