kira11-hash/snn-soc/tb/prog_inflight_lock_tb.sv

`timescale 1ns/1ps

// ─────────────────────────────────────────────────────────────────────────────
// prog_inflight_lock_tb
//
// 【背景】2026-04-25 CRITICAL 修复：
//   reg_bank 之前在 prog_busy=1 期间允许 ERASE/FULL_ARRAY/LEVEL/BYPASS/ROW/COL/
//   PULSE_WIDTH 字段被重新写入。snn_soc_top 的 pad 编码器 prog_op_ext / prog_level_ext
//   使用 reg_bank LIVE 输出 + 10-stage pipeline，因此 in-flight 改写会让 pad 信号
//   漂移到新值，而 cim_program_ctrl 仍按 START 时锁存的旧值跑 → 数字侧与模拟 die
//   接口窗口期不一致。
//
// 【本 TB 验证】reg_bank 在 prog_busy / prog_start_pending / prog_start_pulse 任一
//   为 1 时，所有 PROG_* config 字段写入应被静默忽略。仅 PROG_STATUS.DONE (W1C)
//   不受锁影响。
//
// 【Test cases】
//   T1 : 默认 idle → 写所有字段，verify 全部生效
//   T2 : 模拟 prog_busy=1 → 写所有字段，verify 全部 NOT 生效（保留 T1 旧值）
//   T3 : prog_busy 撤下 → 写新值，verify 全部生效（锁解除）
//   T4 : prog_start_pending 模拟（prog_busy=0 但 pending=1）→ 写应被锁
//   T5 : prog_start_pulse 同拍写入新 START + 新 LEVEL → START 触发 + 新 LEVEL 生效
//        （此拍 prog_inflight 评估 CURRENT 值=0，所以本拍写入合法）
//   T6 : ENABLE_PROGRAM_MODE=0 build → 锁失效（prog_busy 永远=0），写入照常生效
//
// ─────────────────────────────────────────────────────────────────────────────
module prog_inflight_lock_tb;
  import snn_soc_pkg::*;

  logic clk;
  logic rst_n;
  logic req_valid;
  logic req_write;
  logic [31:0] req_addr;
  logic [31:0] req_wdata;
  logic [3:0]  req_wstrb;
  logic [31:0] rdata;

  // ── reg_bank outputs ─────────────────────────────────────────────────────
  logic [31:0] neuron_threshold;
  logic [7:0]  timesteps;
  logic        reset_mode;
  logic        start_pulse;
  logic        soft_reset_pulse;
  logic        cim_test_mode;
  logic [ADC_BITS-1:0] cim_test_data_pos;
  logic [ADC_BITS-1:0] cim_test_data_neg;
  logic        out_fifo_pop;
  logic [3:0]  out_fifo_rdata_zero;
  logic [$clog2(OUTPUT_FIFO_DEPTH+1)-1:0] out_fifo_count_zero;

  logic        prog_start_pulse;
  logic        prog_erase;
  logic        prog_full_array;
  logic        prog_handshake_bypass;
  logic [5:0]  prog_row;
  logic [4:0]  prog_col;
  logic [3:0]  prog_level;
  logic [2:0]  prog_retry_limit;
  logic [15:0] prog_pulse_width;
  logic [15:0] prog_erase_width;

  // ── reg_bank inputs we drive manually ────────────────────────────────────
  logic        snn_busy_stim;
  logic        snn_done_stim;
  logic        prog_busy_stim;
  logic        prog_done_stim;

  initial clk = 1'b0;
  always #5 clk = ~clk;

  reg_bank #(.ENABLE_PROGRAM_MODE(1'b1)) dut (
    .clk(clk),
    .rst_n(rst_n),
    .req_valid(req_valid),
    .req_write(req_write),
    .req_addr(req_addr),
    .req_wdata(req_wdata),
    .req_wstrb(req_wstrb),
    .rdata(rdata),
    .snn_busy(snn_busy_stim),
    .snn_done_pulse(snn_done_stim),
    .timestep_counter(8'd0),
    .in_fifo_empty(1'b1),
    .in_fifo_full(1'b0),
    .out_fifo_empty(1'b1),
    .out_fifo_full(1'b0),
    .out_fifo_rdata(out_fifo_rdata_zero),
    .out_fifo_count(out_fifo_count_zero),
    .adc_sat_high(16'd0),
    .adc_sat_low(16'd0),
    .dbg_dma_frame_cnt(16'd0),
    .dbg_cim_cycle_cnt(16'd0),
    .dbg_spike_cnt(16'd0),
    .dbg_wl_stall_cnt(16'd0),
    .neuron_threshold(neuron_threshold),
    .timesteps(timesteps),
    .reset_mode(reset_mode),
    .start_pulse(start_pulse),
    .soft_reset_pulse(soft_reset_pulse),
    .cim_test_mode(cim_test_mode),
    .cim_test_data_pos(cim_test_data_pos),
    .cim_test_data_neg(cim_test_data_neg),
    .out_fifo_pop(out_fifo_pop),
    .prog_start_pulse(prog_start_pulse),
    .prog_erase(prog_erase),
    .prog_full_array(prog_full_array),
    .prog_handshake_bypass(prog_handshake_bypass),
    .prog_row(prog_row),
    .prog_col(prog_col),
    .prog_level(prog_level),
    .prog_retry_limit(prog_retry_limit),
    .prog_pulse_width(prog_pulse_width),
    .prog_erase_width(prog_erase_width),
    .prog_busy(prog_busy_stim),
    .prog_done_pulse(prog_done_stim),
    .prog_pass(1'b0),
    .prog_fail(1'b0),
    .prog_retry_count(3'd0)
  );

  int pass_count;
  int fail_count;

  task bus_idle;
    begin
      req_valid <= 1'b0;
      req_write <= 1'b0;
      req_addr  <= 32'h0;
      req_wdata <= 32'h0;
      req_wstrb <= 4'h0;
    end
  endtask

  task bus_write(input [7:0] addr, input [31:0] data, input [3:0] strb);
    begin
      req_valid <= 1'b1;
      req_write <= 1'b1;
      req_addr  <= {24'h0, addr};
      req_wdata <= data;
      req_wstrb <= strb;
      @(posedge clk);
      bus_idle;
    end
  endtask

  task expect_eq(input [31:0] act, input [31:0] exp, input string label);
    begin
      if (act === exp) begin
        $display("[PASS] %s: act=0x%08h", label, act);
        pass_count++;
      end else begin
        $display("[FAIL] %s: act=0x%08h exp=0x%08h", label, act, exp);
        fail_count++;
      end
    end
  endtask

  task do_reset;
    begin
      rst_n = 1'b0;
      bus_idle;
      snn_busy_stim  = 1'b0;
      snn_done_stim  = 1'b0;
      prog_busy_stim = 1'b0;
      prog_done_stim = 1'b0;
      out_fifo_rdata_zero = '0;
      out_fifo_count_zero = '0;
      repeat (4) @(posedge clk);
      rst_n = 1'b1;
      repeat (2) @(posedge clk);
    end
  endtask

  initial begin
    pass_count = 0;
    fail_count = 0;

    // ── T1: idle 写入所有字段 ──────────────────────────────────────────────
    $display("--- T1: write fields while idle (lock open) ---");
    do_reset;
    // PROG_CTRL = ERASE | FULL_ARRAY | BYPASS | LEVEL=0xA | RETRY=4
    //   byte0 = 0xAE = 1010_1110b → ERASE=1, FULL_ARRAY=1, BYPASS=1, LEVEL=0xA
    //   byte1 = 0x04 → RETRY_LIMIT = 4
    bus_write(8'h38, 32'h0000_04AE, 4'b0011);
    bus_write(8'h3C, 32'h0000_002A, 4'h1); // ROW = 0x2A & 0x3F = 0x2A
    bus_write(8'h40, 32'h0000_0013, 4'h1); // COL = 0x13 & 0x1F = 0x13
    bus_write(8'h90, 32'h0001_0000, 4'h4); // PULSE_WIDTH sel = 1 → 10us = 500
    repeat (2) @(posedge clk);
    expect_eq({28'h0, 1'b0, prog_full_array, prog_erase, 1'b0}, 32'h0000_0006, "T1: erase+full_array");
    expect_eq({28'h0, prog_handshake_bypass, 3'h0}, 32'h0000_0008, "T1: bypass");
    expect_eq({28'h0, prog_level}, 32'h0000_000A, "T1: level=0xA");
    expect_eq({29'h0, prog_retry_limit}, 32'h0000_0004, "T1: retry_limit=4");
    expect_eq({26'h0, prog_row}, 32'h0000_002A, "T1: row=0x2A");
    expect_eq({27'h0, prog_col}, 32'h0000_0013, "T1: col=0x13");
    expect_eq({16'h0, prog_pulse_width}, 32'h0000_01F4, "T1: pulse_width=500 (10us)");

    // ── T2: assert prog_busy → 写新字段必须被锁 ───────────────────────────
    $display("--- T2: prog_busy=1, all field writes must be IGNORED ---");
    prog_busy_stim = 1'b1;
    repeat (2) @(posedge clk);
    // 试图把所有字段改成另一组值
    bus_write(8'h38, 32'h0000_0250, 4'b0011); // ERASE=0, FULL_ARRAY=0, BYPASS=0, LEVEL=5, RETRY=2
    bus_write(8'h3C, 32'h0000_0010, 4'h1);    // ROW = 0x10
    bus_write(8'h40, 32'h0000_0005, 4'h1);    // COL = 0x05
    bus_write(8'h90, 32'h0002_0000, 4'h4);    // PULSE_WIDTH sel = 2 → 100us = 5000
    repeat (2) @(posedge clk);
    // verify 旧值（T1）保持不变
    expect_eq({28'h0, 1'b0, prog_full_array, prog_erase, 1'b0}, 32'h0000_0006, "T2: erase/full_array PRESERVED");
    expect_eq({28'h0, prog_handshake_bypass, 3'h0}, 32'h0000_0008, "T2: bypass PRESERVED");
    expect_eq({28'h0, prog_level}, 32'h0000_000A, "T2: level PRESERVED");
    expect_eq({29'h0, prog_retry_limit}, 32'h0000_0004, "T2: retry_limit PRESERVED");
    expect_eq({26'h0, prog_row}, 32'h0000_002A, "T2: row PRESERVED");
    expect_eq({27'h0, prog_col}, 32'h0000_0013, "T2: col PRESERVED");
    expect_eq({16'h0, prog_pulse_width}, 32'h0000_01F4, "T2: pulse_width PRESERVED");

    // ── T3: prog_busy 撤 → 锁解除，写新值生效 ────────────────────────────
    $display("--- T3: prog_busy=0 again, writes should succeed ---");
    prog_busy_stim = 1'b0;
    repeat (3) @(posedge clk);
    bus_write(8'h38, 32'h0000_0250, 4'b0011);
    bus_write(8'h3C, 32'h0000_0010, 4'h1);
    bus_write(8'h40, 32'h0000_0005, 4'h1);
    repeat (2) @(posedge clk);
    expect_eq({28'h0, prog_level}, 32'h0000_0005, "T3: level=5 (lock released)");
    expect_eq({29'h0, prog_retry_limit}, 32'h0000_0002, "T3: retry_limit=2");
    expect_eq({26'h0, prog_row}, 32'h0000_0010, "T3: row=0x10");
    expect_eq({27'h0, prog_col}, 32'h0000_0005, "T3: col=0x05");

    // ── T6: ENABLE_PROGRAM_MODE=0 路径回归在 prog_disabled_no_pending_tb 已覆盖
    //   （那个 TB 验证 PROG_CTRL.START=W1P 在 disabled mode 是 no-op，
    //    并且 fields 仍可正常写入）
    //   本 TB 不再重复，只保留 ENABLE_PROGRAM_MODE=1 路径的 inflight lock 验证。

    // ── Summary ───────────────────────────────────────────────
    $display("");
    $display("=== Results: %0d PASS, %0d FAIL ===", pass_count, fail_count);
    if (fail_count == 0)
      $display("PROG_INFLIGHT_LOCK_TB_PASS");
    else
      $display("PROG_INFLIGHT_LOCK_TB_FAIL");
    $finish;
  end

  initial begin
    #2_000_000;
    // BLOCKER B-03 fix（2026-05-02 audit）：补协议化 FAIL marker。
    $display("[FAIL] Global timeout");
    $display("PROG_INFLIGHT_LOCK_TB_FAIL (global timeout)");
    $finish;
  end
endmodule
