kira11-hash/snn-soc/rtl/reg/reg_bank.sv

// =============================================================================
// 【面试讲解 cheat sheet · reg_bank.sv】 —— 设计者视角，能直接拿去答辩
//
// 一、它在 SoC 里的位置
//   软件 (TB master / E203) → bus_interconnect → reg_bank slave。
//   它是"软件控制 SNN 数据通路"的唯一窗口；同时把 SNN/PROG FSM 的状态
//   sticky-latch 给软件轮询。可以理解成"软-硬之间的 contract surface"。
//
// 二、面试最容易被问到的 3 个点
//   1) START 怎么是 W1P（write-1-to-pulse）？为什么不用 RW？
//      用 RW 的话软件必须自己清 0，否则 FSM 会重复触发。W1P 让硬件自动
//      只产生 1 拍 start_pulse，软件写 1 即"扣扳机"，不需要再写 0 复位。
//      实现上靠 always_ff 块的"先默认 0，case 内赋 1"——SV 后赋值覆盖
//      语义保证只在写入那拍输出 1 cycle 高电平。这是 RTL 设计经典套路。
//
//   2) DONE 怎么是 W1C？为什么不直接镜像 snn_done_pulse？
//      snn_done_pulse 只持续 1 拍，软件不可能保证那一拍正在 polling。
//      所以我用 done_sticky 把它锁存住，软件读 DONE=1 就知道完成了，
//      然后写 1 主动清——既能轮询也不会丢事件。如果 sticky 改成"软件
//      读自动清"会怎样？容易和 fifo_sync 的 first-word fall-through
//      合谋出竞争窗口；W1C 把"清"权交给软件，行为最确定。
//
//   3) PROG_* 字段为什么要 in-flight lock（V1.1, 2026-04-25 加的硬保护）？
//      这是这个文件最值得讲的设计点：
//      - cim_program_ctrl 在 ST_IDLE→START 那一拍把 ERASE/FULL_ARRAY/
//        LEVEL/BYPASS/ROW/COL 锁存到 FSM 内部寄存器；
//      - 但 snn_soc_top 的 pad 编码器 (prog_op_ext / prog_level_ext)
//        用的是 reg_bank LIVE 输出 + 10-stage shift register；
//      - 如果 CPU 在 prog_busy=1 期间改了这些字段，10 拍后 pad 信号就会
//        漂到新值，而 cim_program_ctrl 还在按旧 op 跑——数字侧 FSM 与
//        模拟 die 的 op/level pad 不一致，写到错误 cell。
//      解决：定义 wire prog_inflight = ENABLE_PROGRAM_MODE && (prog_busy
//        || prog_start_pending || prog_start_pulse)；inflight 期间所有
//        config 字段写入被屏蔽。注意 PROG_STATUS.DONE (W1C) 与 PROG_CTRL.
//        START (已有三重守卫) 不受 inflight 锁影响——前者要随时清，
//        后者本身有 !prog_busy && !prog_start_pulse 守卫已足够。
//      ENABLE_PROGRAM_MODE=0 时 prog_inflight 恒 0，无锁版本完全等价
//        ——保持 build 矩阵里"不实例化 FSM"的 zero-cost 路径不被打扰。
//
// 三、关键设计指标
//   - simple_bus 1-cycle 响应（写 0、读组合输出）；不做 wait-state。
//   - 只读寄存器 (NUM_INPUTS / NUM_OUTPUTS / OUT_COUNT / DBG_CNT) 在
//     bus 读组合输出，不占额外寄存器拍。
//   - OUT_FIFO 读路径用 2-cycle pop_pending 把"读"和"实际 pop"分开拍——
//     这是面试容易考的"FIFO + bus 时序"经典坑。
//
// 四、不做的事 / trade-off
//   - 没接中断控制器：V1 全程轮询，DONE/STATUS 是 sticky；面试如果被问
//     "为什么不上中断"，答："MVP 阶段 SW 跑在 TB / 单线程裸机上，轮询
//     成本可忽略；中断控制器留到 V2 多任务 OS 上来加。"
//   - DBG 计数器只随 rst_n 清零，不随 soft_reset_pulse 清零：故意的——
//     soft reset 之后我还想看到累计 dma frame / cim cycle 数，便于对比
//     "重置前后" 是不是同一行为。
// =============================================================================

// -----------------------------------------------------------------------------
// AUTO-DOC-HEADER: Detailed readability notes for this file (comments only, no logic change)
// File: rtl/reg/reg_bank.sv
// Purpose: Central memory-mapped control/status register bank for SNN datapath and runtime configuration.
// Role in system: Software/testbench programs thresholds, timesteps, start/reset controls, and reads status/outputs here.
// Behavior summary: Decodes register offsets, handles writes/reads, exposes clean control wires to datapath blocks.
// Important distinction: Some fields are "shadow/metadata" values (e.g., threshold ratio) while others directly drive hardware.
// Verification focus: Bitfield definitions, sticky status semantics, and alignment with doc/02_reg_map.md.
// Evolution note: This file is the primary compatibility surface when E203/UART firmware takes over from the TB master.
// -----------------------------------------------------------------------------

`timescale 1ns/1ps
//======================================================================
// 文件名: reg_bank.sv
// 描述: SNN SoC 主寄存器 Bank。
//       - 地址基址：0x4000_0000
//       - 提供阈值、时步数、控制与状态寄存器
//       - CIM_CTRL.DONE 为 sticky，使用 W1C 清零
//       - CIM_CTRL.START/RESET 为 W1P，写 1 仅产生单拍脉冲
//======================================================================
// TIMESTEPS 表示帧数；每帧包含 PIXEL_BITS 个子时间步（MSB->LSB）。
//
// -----------------------------------------------------------------------
// 寄存器地址映射（物理地址 = 0x4000_0000 + offset）：
//
//   0x00  REG_THRESHOLD      [31:0]  LIF 神经元绝对阈值（直接驱动 neuron_threshold）
//   0x04  REG_TIMESTEPS      [7:0]   推理时步数（即帧数，工程默认=10）
//   0x08  REG_NUM_INPUTS     [15:0]  只读：NUM_INPUTS 参数值（=64）
//   0x0C  REG_NUM_OUTPUTS    [7:0]   只读：NUM_OUTPUTS 参数值（=10）
//   0x10  REG_RESET_MODE     [0]     重置模式选择（0=soft/1=hard）
//   0x14  REG_CIM_CTRL       [7:0]   控制/状态复合寄存器：
//                                      bit[0] START      W1P  写 1 产生 1 拍 start_pulse
//                                      bit[1] SOFT_RESET W1P  写 1 产生 1 拍 soft_reset_pulse
//                                      bit[7] DONE       W1C  sticky，推理完成后由硬件置 1，写 1 清零
//   0x18  REG_STATUS         只读：
//                                      bit[0]    snn_busy
//                                      bit[1]    in_fifo_empty
//                                      bit[2]    in_fifo_full
//                                      bit[3]    out_fifo_empty
//                                      bit[4]    out_fifo_full
//                                      bit[15:8] timestep_counter（当前时步）
//   0x1C  REG_OUT_DATA       [3:0]   只读：弹出 output_fifo 的 spike_id（读后自动 pop）
//   0x20  REG_OUT_COUNT      只读：output_fifo 当前 entry 数
//   0x24  REG_THRESHOLD_RATIO [7:0]  shadow 寄存器：Scheme B 阈值比例（定版默认 1 ≈ 0.392%）
//                                     注意：此寄存器不驱动硬件，固件需手动计算后写 REG_THRESHOLD
//   0x28  REG_ADC_SAT_COUNT  只读：{adc_sat_low[31:16], adc_sat_high[15:0]}
//   0x2C  REG_CIM_TEST       bit[0]=cim_test_mode, bit[15:8]=cim_test_data_pos（正通道 ch0~9）, bit[23:16]=cim_test_data_neg（负通道 ch10~19）
//   0x30  REG_DBG_CNT_0      只读：{cim_cycle_cnt[31:16], dma_frame_cnt[15:0]}
//   0x34  REG_DBG_CNT_1      只读：{wl_stall_cnt[31:16], spike_cnt[15:0]}
//
// -----------------------------------------------------------------------
// 写操作语义说明：
//
//   W1P（Write-1-to-Pulse）：START（bit0）和 SOFT_RESET（bit1）
//     实现机制：
//       1. always_ff 开头默认：start_pulse <= 0; soft_reset_pulse <= 0;（每拍清零）
//       2. case(addr_offset) 中 REG_CIM_CTRL 分支：若 req_wdata[0]=1 则 start_pulse <= 1
//       3. 因为是同一 always_ff 块，第 2 步的赋值覆盖第 1 步默认值
//       4. 下一拍开头第 1 步再次清零 → 只产生 1 拍脉冲
//     注意：默认清零必须在 case 之前，否则 case 内赋值会被覆盖。
//     这是 SystemVerilog always_ff 中"后赋值覆盖"语义，安全且符合规范。
//
//   W1C（Write-1-to-Clear）：DONE（bit7）
//     实现机制：
//       1. 硬件置位：snn_done_pulse=1 时，done_sticky <= 1
//       2. 软件清零：写 REG_CIM_CTRL 且 req_wdata[7]=1 时，done_sticky <= 0
//       3. 两者在同一 always_ff 中，若同拍 done_pulse 和 W1C 同时发生，
//          case 内的 done_sticky <= 0 比 if(snn_done_pulse) done_sticky <= 1 后执行
//          → 清零优先（SystemVerilog last-assignment 语义）
//          → 固件如需确认完成，应在 snn_done_pulse 之后再读 DONE
//
//   sticky DONE 语义：
//     snn_done_pulse 是 SNN 子系统发出的 1 拍完成脉冲。
//     done_sticky 将其"锁存"，CPU 可以在稍后（多个总线周期后）轮询到 DONE=1。
//     与中断类似，但通过轮询实现（V1 无中断控制器）。
//
// -----------------------------------------------------------------------
// OUT_FIFO 读取的 2-cycle pipeline（pop_pending 机制）：
//
//   目的：避免"同拍读出 rd_data 同拍 pop"导致数据竞争。
//   fifo_sync 是 first-word fall-through：rd_data = mem[rd_ptr] 是组合读。
//   若同拍 pop（rd_ptr 推进），rd_data 会立即切换，可能导致总线读到下一个数据。
//
//   解决方案（2 拍流水）：
//     Cycle 0: CPU 读 REG_OUT_DATA → rdata 组合读出 rd_data（当前队头）
//              → pop_pending <= 1（但此刻 out_fifo_pop 还是 0）
//     Cycle 1: out_fifo_pop <= pop_pending（= 1）→ FIFO 实际 pop
//              → pop_pending <= 0（除非又来一次读）
//
//   关键：CPU 在 Cycle 0 读到的是 pop 发生前的队头，时序正确，无竞争。
//
//   pop_pending 的触发条件：req_valid && !req_write && addr_offset==REG_OUT_DATA && !out_fifo_empty
//     - 必须 !out_fifo_empty：空 FIFO 读不应触发 pop（避免 underflow）
//     - 必须是有效读请求（req_valid && !req_write）
// -----------------------------------------------------------------------
module reg_bank #(
  // When the programming FSM is not instantiated, PROG_CTRL.START must behave
  // as a no-op rather than leaving a pending interlock behind.
  parameter bit ENABLE_PROGRAM_MODE = 1'b1
) (
  input  logic        clk,
  input  logic        rst_n,

  // 简化总线接口（地址为 offset）
  // req_addr[7:0] 为寄存器偏移，高位忽略（见 _unused lint 处理）
  input  logic        req_valid,
  input  logic        req_write,
  input  logic [31:0] req_addr,
  input  logic [31:0] req_wdata,
  input  logic [3:0]  req_wstrb,
  output logic [31:0] rdata,

  // 来自 SNN 子系统的状态输入
  input  logic        snn_busy,          // SNN 推理进行中（高电平有效）
  input  logic        snn_done_pulse,    // SNN 推理完成脉冲（1 拍，用于置 done_sticky）
  input  logic [7:0]  timestep_counter,  // 当前时步计数器（用于 STATUS 状态读回）

  // FIFO 状态
  input  logic        in_fifo_empty,    // 输入 FIFO 空（DMA 尚未写入或全被消耗）
  input  logic        in_fifo_full,     // 输入 FIFO 满（DMA 暂停）
  input  logic        out_fifo_empty,   // 输出 FIFO 空（无 spike 可读）
  input  logic        out_fifo_full,    // 输出 FIFO 满（LIF 暂停输出）
  input  logic [3:0]  out_fifo_rdata,   // 输出 FIFO 队头 spike_id（4-bit，fall-through）
  input logic [$clog2(snn_soc_pkg::OUTPUT_FIFO_DEPTH+1)-1:0] out_fifo_count, // 当前 spike 数量

  // ADC 饱和监控（来自 adc_ctrl）
  // adc_sat_high: 高阈值饱和次数（ADC 输出 >= 最大正值）
  // adc_sat_low : 低阈值饱和次数（ADC 输出 <= 最大负值）
  input  logic [15:0] adc_sat_high,
  input  logic [15:0] adc_sat_low,

  // Debug 计数器（来自 snn_soc_top 内部采样，只读）
  input  logic [15:0] dbg_dma_frame_cnt,  // DMA 已传输的帧数
  input  logic [15:0] dbg_cim_cycle_cnt,  // CIM 推理总时钟周期数
  input  logic [15:0] dbg_spike_cnt,      // 输出 spike 总数
  input  logic [15:0] dbg_wl_stall_cnt,   // WL 总线停顿次数

  // 输出到 SNN 子系统
  output logic [31:0] neuron_threshold,   // 直接驱动 LIF 神经元阈值
  output logic [7:0]  timesteps,          // 推理时步数（帧数）
  output logic        reset_mode,         // 0=soft reset，1=hard reset
  output logic        start_pulse,        // 1 拍脉冲，触发 SNN 推理开始（W1P）
  output logic        soft_reset_pulse,   // 1 拍脉冲，触发软复位（W1P）

  // CIM Test Mode 输出
  // cim_test_mode=1 时，cim_macro_blackbox 用合成数据替代真实 RRAM 响应
  // cim_test_data_pos：正通道（ch 0~9）合成 ADC 值；cim_test_data_neg：负通道（ch 10~19）合成 ADC 值
  // 将两者设置为不同值（如 pos=100, neg=0）可使 Scheme B 差分非零，LIF 膜电位可积累并产生 spike
  output logic        cim_test_mode,
  output logic [snn_soc_pkg::ADC_BITS-1:0] cim_test_data_pos, // 正通道合成值（8-bit，ch 0~9）
  output logic [snn_soc_pkg::ADC_BITS-1:0] cim_test_data_neg, // 负通道合成值（8-bit，ch 10~19）

  // 输出 FIFO 弹出控制（在 rvalid 那拍）
  // 由 pop_pending 2-cycle pipeline 驱动，确保读出后下一拍才 pop
  output logic        out_fifo_pop,

  // ── CIM 编程寄存器（2026-04-22 从 v2 移植）──────────────────────────
  // 输出：送给 cim_program_ctrl
  output logic        prog_start_pulse, // W1P 启动编程序列
  output logic        prog_erase,       // 0=SET 写入，1=RESET 擦除
  output logic        prog_full_array,  // 全阵列擦除（仅 erase=1 时生效）
  // Silicon bring-up: bypass prog_adc_done handshake so cim_program_ctrl
  // can complete without a responding analog macro.  When set, verify
  // always returns PASS with ideal readback value (erase=0, write=level*16).
  // Intended for post-silicon digital self-test only; leave 0 in normal flow.
  output logic        prog_handshake_bypass,
  output logic [5:0]  prog_row,         // 目标行（0~63）
  output logic [4:0]  prog_col,         // 目标列（0~19）
  output logic [3:0]  prog_level,       // 目标等级（0~15）
  output logic [2:0]  prog_retry_limit, // verify 失败最大重试次数
  output logic [15:0] prog_pulse_width, // 写入脉冲宽度（cycles，由 preset 解出）
  output logic [15:0] prog_erase_width, // 擦除脉冲宽度（cycles，固定 50000）

  // 输入：来自 cim_program_ctrl（状态读回）
  input  logic        prog_busy,
  input  logic        prog_done_pulse,
  input  logic        prog_pass,
  input  logic        prog_fail,
  input  logic [2:0]  prog_retry_count
);
  import snn_soc_pkg::*;

  // -----------------------------------------------------------------------
  // 寄存器偏移地址常量（相对于模块挂载基址 0x4000_0000）
  // 每个常量对应一个逻辑寄存器的字节地址偏移（4B 对齐）
  // -----------------------------------------------------------------------
  // 寄存器 offset
  localparam logic [7:0] REG_THRESHOLD   = 8'h00; // 阈值（32-bit，直接驱动硬件）
  localparam logic [7:0] REG_TIMESTEPS   = 8'h04; // 时步数/帧数（8-bit）
  localparam logic [7:0] REG_NUM_INPUTS  = 8'h08; // 只读：NUM_INPUTS 参数（=64）
  localparam logic [7:0] REG_NUM_OUTPUTS = 8'h0C; // 只读：NUM_OUTPUTS 参数（=10）
  localparam logic [7:0] REG_RESET_MODE  = 8'h10; // 复位模式（1-bit）
  localparam logic [7:0] REG_CIM_CTRL    = 8'h14; // 复合控制：START W1P / SOFT_RESET W1P / DONE W1C
  localparam logic [7:0] REG_STATUS      = 8'h18; // 只读状态：busy/fifo flags/timestep_counter
  localparam logic [7:0] REG_OUT_DATA    = 8'h1C; // 只读：output_fifo 队头 spike_id（读触发 pop）
  localparam logic [7:0] REG_OUT_COUNT   = 8'h20; // 只读：output_fifo 当前 entry 数
  // Scheme B 阈值比例寄存器（8-bit, 定版默认 1/255 ≈ 0.00392）
  // 固件可读取 ratio 辅助计算绝对阈值，或直接用于 bring-up 调试
  // THRESHOLD_RATIO is a software/debug-visible ratio shadow register only.
  // Writing REG_THRESHOLD_RATIO does NOT auto-update neuron_threshold.
  // Firmware should compute absolute threshold and write REG_THRESHOLD explicitly.
  localparam logic [7:0] REG_THRESHOLD_RATIO = 8'h24; // shadow 寄存器，不驱动硬件
  // ADC 饱和计数（只读，由 adc_ctrl 驱动，每次推理自动清零）
  localparam logic [7:0] REG_ADC_SAT_COUNT   = 8'h28; // {sat_low[31:16], sat_high[15:0]}
  // CIM Test Mode: bit[0]=test_mode, bit[15:8]=test_data_pos(ch0~9), bit[23:16]=test_data_neg(ch10~19)
  localparam logic [7:0] REG_CIM_TEST        = 8'h2C; // bit[0]=test_mode, bit[15:8]=test_data_pos(ch0~9), bit[23:16]=test_data_neg(ch10~19)
  // Debug 计数器（只读，打包两组 16-bit）
  localparam logic [7:0] REG_DBG_CNT_0       = 8'h30; // [15:0]=dma_frame, [31:16]=cim_cycle
  localparam logic [7:0] REG_DBG_CNT_1       = 8'h34; // [15:0]=spike, [31:16]=wl_stall

  // CIM 编程寄存器（2026-04-22 从 v2 移植）
  localparam logic [7:0] REG_PROG_CTRL        = 8'h38; // [0]=START W1P, [1]=ERASE RW, [2]=FULL_ARRAY RW, [3]=BYPASS_HANDSHAKE RW, [7:4]=LEVEL RW, [10:8]=RETRY_LIMIT RW
  localparam logic [7:0] REG_PROG_ROW         = 8'h3C; // [5:0]=row (0~63)
  localparam logic [7:0] REG_PROG_COL         = 8'h40; // [4:0]=col (0~19)
  localparam logic [7:0] REG_PROG_STATUS      = 8'h44; // [0]=BUSY RO, [1]=PASS RO, [2]=FAIL RO, [5:3]=RETRY_COUNT RO, [6]=PROG_FSM_PRESENT RO, [7]=DONE W1C
  localparam logic [7:0] REG_PROG_PULSE_WIDTH = 8'h90; // [17:16]=sel RW (0=1us/1=10us/2=100us/3=reserved->100us); [15:0]=resolved cycles RO
  localparam logic [7:0] REG_PROG_ERASE_WIDTH = 8'h94; // [15:0]=erase cycles RO (fixed 50000=1ms, writes ignored)

  // -----------------------------------------------------------------------
  // 内部寄存器说明
  // threshold_ratio : Scheme B 阈值比例 shadow（不驱动硬件，仅 SW 可见）
  // done_sticky     : SNN 完成 sticky 标志（snn_done_pulse 置位，W1C 清零）
  // pop_pending     : OUT_FIFO pop 流水线第一级（读 REG_OUT_DATA 的下一拍触发 pop）
  // prog_*          : CIM 编程寄存器状态 + sticky DONE（V1 单层编程能力）
  // -----------------------------------------------------------------------
  logic [7:0] threshold_ratio;
  logic done_sticky;
  logic pop_pending;
  logic out_data_read_seen;

  // CIM programming internal state
  logic prog_done_sticky;         // prog_done_pulse sticky, W1C via REG_PROG_STATUS[7]
  logic [1:0] prog_write_pulse_sel; // 写入脉冲档位选择（0=1us, 1=10us, 2=100us, 3=保留）

  // -----------------------------------------------------------------------
  // START pending guards（2026-04-22 GPT review Q2 修复：back-to-back race）
  //
  // 【问题】 仅用 `!snn_busy` / `!prog_busy` 屏蔽 START 无法防御 back-to-back 写：
  //   Cycle N  : 写 CIM_CTRL.START=1 → start_pulse <= 1（prog_busy=0 通过互锁）
  //   Cycle N+1: start_pulse 此拍 visible，但 snn_busy 还要下一拍（N+2）才拉高
  //              若 CPU 此拍写 PROG_CTRL.START=1，!snn_busy 仍然为真，
  //              prog_start_pulse 也会被置 → 两条 FSM 同时启动。
  //
  // 【修复】 额外加两个 pending 位：
  //   - snn_start_pending : start_pulse 发出后置 1，直到 snn_busy 升起才清零
  //   - prog_start_pending: 同理；当 ENABLE_PROGRAM_MODE=0 时保持 0，
  //     因为 PROG_CTRL.START 没有下游 FSM 可消费，必须是 no-op。
  //
  // 【互锁条件加强为】：
  //   start_pulse 允许  = !prog_busy && !prog_start_pending && !prog_start_pulse
  //   prog_start 允许  = !snn_busy  && !snn_start_pending  && !start_pulse
  //
  // 三重守卫：busy（下游已在忙）+ pending（已发出 START 但下游还没到 busy）+
  //           start_pulse（本拍正在发 START，最激进的 back-to-back 情形）。
  //
  // downstream FSM 延迟容忍：不管 snn_busy 落后几拍，pending 一定在第 1 个 edge
  // 后就为 1，至少提供 1 拍 race-free 窗口。
  // -----------------------------------------------------------------------
  logic snn_start_pending;
  logic prog_start_pending;

  // -----------------------------------------------------------------------
  // PROG_* in-flight 字段写锁（2026-04-25 修复 CRITICAL: pad 编码器 LIVE 信号）
  //
  // 【问题】 reg_bank 之前只在 `prog_busy` 期间挡 PROG_CTRL.START 的 W1P，但允许
  //   ERASE / FULL_ARRAY / LEVEL / BYPASS / ROW / COL / PULSE_WIDTH 在 busy 期间被
  //   重新写入。cim_program_ctrl 在 ST_IDLE START 那一拍把这些值锁存到内部
  //   op_*/target_* 寄存器，因此 FSM 自己不会受影响；但 snn_soc_top 的 pad 编码器
  //   （prog_op_ext / prog_level_ext）使用 reg_bank 的 LIVE 输出 + 10 级 pipeline，
  //   一旦 CPU 在 prog_busy=1 时改写这些位，10 拍后 pad 信号就会从原 op 漂移到新值，
  //   而 cim_program_ctrl 还在按旧 op 跑 → 数字侧与模拟 die 接口不一致。
  //
  // 【修复】 把 prog_busy / prog_start_pending / prog_start_pulse 任何一个为 1 都视
  //   为 "in-flight"，期间所有 PROG_* 配置字段写入被屏蔽：
  //     - PROG_CTRL.{ERASE, FULL_ARRAY, BYPASS_HANDSHAKE, LEVEL, RETRY_LIMIT}
  //     - PROG_ROW / PROG_COL
  //     - PROG_PULSE_WIDTH
  //   仅 PROG_STATUS.DONE (W1C)、PROG_ERASE_WIDTH（已经硬编码 ignore）不受锁。
  //   PROG_CTRL.START 本身已有三重守卫，不需重复。
  //
  // 【ENABLE_PROGRAM_MODE=0】 prog_busy/pending/pulse 全为 0 → prog_inflight=0 →
  //   字段写入照常进行，与无锁版本完全等价。
  //
  // 【验证】 tb/prog_inflight_lock_tb.sv 直接驱动 prog_busy_stim 测三种字段在
  //   busy 前/中/后的写入是否被正确放行/屏蔽。
  // -----------------------------------------------------------------------
  wire prog_inflight =
      ENABLE_PROGRAM_MODE && (prog_busy || prog_start_pending || prog_start_pulse);

  // 将 sel 解码为 resolved cycles；档位 3 被视为保留，回退到最长的 100us（安全默认）。
  function automatic logic [15:0] decode_write_pulse_width(input logic [1:0] sel);
    case (sel)
      2'd0: decode_write_pulse_width = PROG_WRITE_PULSE_1US_CYC[15:0];
      2'd1: decode_write_pulse_width = PROG_WRITE_PULSE_10US_CYC[15:0];
      2'd2: decode_write_pulse_width = PROG_WRITE_PULSE_100US_CYC[15:0];
      // 2'd3 reserved：防止误写"1ms SET 脉冲"烧毁器件，钳到 100us
      default: decode_write_pulse_width = PROG_WRITE_PULSE_100US_CYC[15:0];
    endcase
  endfunction

  // addr_offset 只取低 8 位用于寄存器解码
  wire [7:0] addr_offset = req_addr[7:0];
  // write_en: 总线有效且为写操作时拉高
  wire write_en = req_valid && req_write;
  // 标记未使用高位（lint 友好）
  // req_addr[31:8]: 高位用于顶层 bus_interconnect 路由，本模块不使用
  // req_wstrb[3:2]: 暂未用于任何字节精确写逻辑（当前只有 byte0/byte1 被精确控制）
  wire _unused = &{1'b0, req_addr[31:8]}; // wstrb[3:0] 均被使用（threshold byte-write / cim_test）

  // -----------------------------------------------------------------------
  // 主寄存器写逻辑（同步时序）
  //
  // 结构说明：
  //   1. 复位后设置所有寄存器默认值（来自 snn_soc_pkg 参数）
  //   2. always_ff 开头：start_pulse/soft_reset_pulse 默认清零（W1P 机制的关键）
  //   3. sticky DONE 检测：snn_done_pulse 高时置 done_sticky
  //   4. case 写解码：写寄存器和 W1P/W1C 处理
  //
  // W1P 安全性分析：
  //   默认清零（step 2）先执行，case 分支（step 4）后执行，
  //   后赋值覆盖前赋值 → start_pulse/soft_reset_pulse 仅在写入拍为 1，
  //   下一拍再次被步骤 2 清零 → 精确 1 拍脉冲。
  //
  // W1C 与 sticky 同拍竞争：
  //   若同一拍 snn_done_pulse=1 且 CPU 写 DONE W1C=1：
  //     - if(snn_done_pulse) done_sticky <= 1  （先执行）
  //     - case: if(req_wdata[7]) done_sticky <= 0（后执行，覆盖）
  //   结果：清零优先（SystemVerilog last-write-wins）
  //   这在实践中极少发生，且清零优先是合理行为（CPU 认为已处理）。
  // -----------------------------------------------------------------------
  // 产生 W1P 脉冲（默认 0）
  always_ff @(posedge clk or negedge rst_n) begin
    if (!rst_n) begin
      // 复位值来自 snn_soc_pkg 参数（保证与包定义一致）
      neuron_threshold  <= THRESHOLD_DEFAULT[31:0];      // 默认阈值
      timesteps         <= TIMESTEPS_DEFAULT[7:0];       // 默认时步数
      threshold_ratio   <= THRESHOLD_RATIO_DEFAULT[7:0]; // 默认比例 1（定版 ratio_code=1）
      reset_mode        <= 1'b0;
      start_pulse      <= 1'b0;
      soft_reset_pulse <= 1'b0;
      done_sticky      <= 1'b0;
      cim_test_mode     <= 1'b0;
      cim_test_data_pos <= '0;
      cim_test_data_neg <= '0;
      // CIM 编程寄存器复位（来自 snn_soc_pkg 常量）
      prog_start_pulse  <= 1'b0;
      prog_erase        <= 1'b0;
      prog_full_array   <= 1'b0;
      prog_handshake_bypass <= 1'b0; // 默认不绕过：真实宏握手
      prog_row          <= 6'd0;
      prog_col          <= 5'd0;
      prog_level        <= 4'd0;
      prog_retry_limit  <= PROG_VERIFY_RETRY_MAX[2:0];
      prog_write_pulse_sel <= 2'd0;
      prog_pulse_width  <= PROG_PULSE_WIDTH_CYC[15:0];
      prog_erase_width  <= PROG_ERASE_WIDTH_CYC[15:0];
      prog_done_sticky  <= 1'b0;
      snn_start_pending  <= 1'b0;
      prog_start_pending <= 1'b0;
    end else begin
      // W1P 默认每拍清零（确保脉冲只有 1 拍宽度）
      // 这两行必须在 case 之前，以便 case 中的赋值可以覆盖它们
      start_pulse      <= 1'b0;
      soft_reset_pulse <= 1'b0;
      prog_start_pulse <= 1'b0;

      // sticky DONE：SNN 推理完成脉冲将 done_sticky 置 1（直到 W1C 清零）
      if (snn_done_pulse) begin
        done_sticky <= 1'b1;
      end
      // CIM 编程完成脉冲 → sticky
      if (prog_done_pulse) begin
        prog_done_sticky <= 1'b1;
      end

      // ─── START pending 跟踪（GPT review Q2 修复）────────────────────
      // start_pulse 此拍=1 说明本拍 reg_bank 正在把 START 交给下游 FSM。
      // 从下一拍开始，snn_start_pending 置 1，直到 snn_busy 升起才清零。
      // snn_busy 清零时（推理结束）pending 已在更早 clear，不会再次阻塞。
      if (start_pulse) begin
        snn_start_pending <= 1'b1;
      end else if (snn_busy) begin
        snn_start_pending <= 1'b0;
      end
      if (!ENABLE_PROGRAM_MODE) begin
        prog_start_pending <= 1'b0;
      end else if (prog_start_pulse) begin
        prog_start_pending <= 1'b1;
      end else if (prog_busy) begin
        prog_start_pending <= 1'b0;
      end

      if (write_en) begin
        case (addr_offset)
          REG_THRESHOLD: begin
            // 字节使能写入 neuron_threshold（32-bit，直接驱动 LIF 神经元）
            if (req_wstrb[0]) neuron_threshold[7:0]   <= req_wdata[7:0];
            if (req_wstrb[1]) neuron_threshold[15:8]  <= req_wdata[15:8];
            if (req_wstrb[2]) neuron_threshold[23:16] <= req_wdata[23:16];
            if (req_wstrb[3]) neuron_threshold[31:24] <= req_wdata[31:24];
          end
          REG_TIMESTEPS: begin
            // 只写 byte0（timesteps 是 8-bit，byte1~3 忽略）
            if (req_wstrb[0]) timesteps <= req_wdata[7:0];
          end
          REG_RESET_MODE: begin
            // 只写 bit0（reset_mode 是 1-bit）
            if (req_wstrb[0]) reset_mode <= req_wdata[0];
          end
          REG_THRESHOLD_RATIO: begin
            // Shadow-only register: keep ratio visible/configurable for firmware,
            // but leave actual threshold control to REG_THRESHOLD.
            // 仅是 SW 可见的比例系数寄存器，不驱动任何硬件信号
            if (req_wstrb[0]) threshold_ratio <= req_wdata[7:0];
          end
          REG_CIM_TEST: begin
            // bit[0]    = cim_test_mode（byte0，wstrb[0]）
            if (req_wstrb[0]) cim_test_mode     <= req_wdata[0];
            // bit[15:8] = cim_test_data_pos（正通道 ch0~9，byte1，wstrb[1]）
            if (req_wstrb[1]) cim_test_data_pos <= req_wdata[15:8];
            // bit[23:16]= cim_test_data_neg（负通道 ch10~19，byte2，wstrb[2]）
            // 建议写法：bus_write(REG_CIM_TEST, {8'h00, neg_val, pos_val, 7'h0, mode})
            //           wstrb=4'b0111 同时写三个字节
            if (req_wstrb[2]) cim_test_data_neg <= req_wdata[23:16];
          end
          REG_CIM_CTRL: begin
            // W1P: START / RESET
            // 这三个控制位都位于 byte0，需同时满足 wstrb[0]=1 才生效
            // 写 bit[0]=1 → start_pulse 被置 1，覆盖本拍开头的默认清零
            // 三重互锁（GPT review Q2 修复）：
            //   - !prog_busy         : 编程控制器 FSM 当前不忙
            //   - !prog_start_pending: 近期没发过 prog_start_pulse 但 prog_busy 还没升起
            //   - !prog_start_pulse  : 本拍 reg_bank 没有同时接受另一个 PROG_CTRL.START
            if (req_wstrb[0] && req_wdata[0]
                && !prog_busy
                && (!prog_start_pending || !ENABLE_PROGRAM_MODE)
                && (!prog_start_pulse || !ENABLE_PROGRAM_MODE)) begin
              start_pulse <= 1'b1;
            end
            // 写 bit[1]=1 → soft_reset_pulse 被置 1，同上
            if (req_wstrb[0] && req_wdata[1]) soft_reset_pulse <= 1'b1;
            // W1C: DONE
            // 写 bit[7]=1 → done_sticky 清零（SW 确认完成）
            if (req_wstrb[0] && req_wdata[7]) done_sticky <= 1'b0;
          end
          REG_PROG_CTRL: begin
            // 推理 + 编程双向互锁：屏蔽在对方 busy 期间重新启动自己。
            //   - !snn_busy / !snn_start_pending / !start_pulse：推理进行中阻塞编程启动
            //   - !prog_busy / !prog_start_pulse：编程进行中阻塞再次启动（2026-04-23 新增，
            //     否则 in-flight bypass/erase/level 会被后续 START 脉冲重新锁存，
            //     导致 cim_program_ctrl 与 snn_soc_top 内部状态不一致 → 莫名其妙 FAIL）
            if (req_wstrb[0] && req_wdata[0]
                && !snn_busy && !snn_start_pending && !start_pulse
                && ENABLE_PROGRAM_MODE && !prog_busy && !prog_start_pulse) begin
              prog_start_pulse <= 1'b1;
            end
            // 【2026-04-25 in-flight 锁】config 字段在 prog_inflight=1 期间不接受写入：
            // 防止 pad 编码器（snn_soc_top.prog_op_ext / prog_level_ext）使用 LIVE
            // 信号被 mid-flight 写入改写，导致 op/level pad 与 cim_program_ctrl 内部
            // 锁存值不一致。注：prog_inflight 用 CURRENT 值评估，本拍的 START 写入
            // 仍能同时写 config 字段（因为 prog_start_pulse 此拍尚未升起）。
            if (req_wstrb[0] && !prog_inflight) prog_erase      <= req_wdata[1];
            if (req_wstrb[0] && !prog_inflight) prog_full_array <= req_wdata[2];
            // bit[3] = BYPASS_HANDSHAKE — silicon bring-up ONLY
            if (req_wstrb[0] && !prog_inflight) prog_handshake_bypass <= req_wdata[3];
            if (req_wstrb[0] && !prog_inflight) prog_level      <= req_wdata[7:4];
            if (req_wstrb[1] && !prog_inflight) prog_retry_limit<= req_wdata[10:8];
          end
          REG_PROG_ROW: begin
            if (req_wstrb[0] && !prog_inflight) prog_row <= req_wdata[5:0];
          end
          REG_PROG_COL: begin
            if (req_wstrb[0] && !prog_inflight) prog_col <= req_wdata[4:0];
          end
          REG_PROG_STATUS: begin
            // W1C: DONE（bit[7]）— 软件确认编程完成（不受 inflight 锁影响，需要随时清）
            if (req_wstrb[0] && req_wdata[7]) prog_done_sticky <= 1'b0;
          end
          REG_PROG_PULSE_WIDTH: begin
            // 档位在 byte2（bits[17:16]），需 wstrb[2]=1
            if (req_wstrb[2] && !prog_inflight) begin
              // 【Q1 fix, 2026-04-22】写入 sel=3（保留档）时同时把 sel 钳到 2'd2，
              // 避免 readback 出现 (sel=3, width=5000) 这种前后矛盾的字段组合。
              // decode_write_pulse_width 已经把 width 钳到 100us，两者在此保持一致。
              prog_write_pulse_sel <= (req_wdata[17:16] == 2'd3) ? 2'd2 : req_wdata[17:16];
              prog_pulse_width     <= decode_write_pulse_width(req_wdata[17:16]);
            end
          end
          REG_PROG_ERASE_WIDTH: begin
            // 擦除脉宽故意硬编码为 1ms，忽略写入（防止误写短脉宽烧伤器件）
            prog_erase_width <= PROG_ERASE_WIDTH_CYC[15:0];
          end
          default: begin
            // 其他地址忽略（包括只读寄存器：写入无效）
          end
        endcase
      end
    end
  end

  // -----------------------------------------------------------------------
  // OUT_FIFO pop 2-cycle pipeline
  //
  // 目的：防止"读出队头数据"与"弹出队头"发生在同一周期，导致读到下一个数据。
  // fifo_sync 是 fall-through FIFO：pop 的同拍 rd_data 就切换为下一个。
  //
  // Cycle N:   CPU 读 REG_OUT_DATA
  //              → rdata 组合读出 out_fifo_rdata（当前队头，正确）
  //              → pop_pending <= 1（下一拍触发 pop）
  //              → out_fifo_pop = pop_pending 上一拍值（=0，本拍不 pop）
  //
  // Cycle N+1: out_fifo_pop <= pop_pending（=1）→ FIFO 实际 pop，rd_ptr 推进
  //              → pop_pending <= 0（无新读请求时）
  //
  // 若连续两拍都读 REG_OUT_DATA（如 for 循环），pop_pending 连续为 1，
  // out_fifo_pop 也连续为 1，正确地逐拍弹出。
  // -----------------------------------------------------------------------
  // OUT_FIFO_DATA 读出后下一拍弹出，避免同拍竞争
  // 同时对读请求做边沿检测，避免 bus_read 在 valid 保持两拍时重复 pop。
  always_ff @(posedge clk or negedge rst_n) begin
    if (!rst_n) begin
      pop_pending <= 1'b0;
      out_fifo_pop <= 1'b0;
      out_data_read_seen <= 1'b0;
    end else begin
      // 第 2 拍：将上一拍的 pop_pending 转化为实际 pop
      out_fifo_pop <= pop_pending;
      // 第 1 拍：仅在新的 OUT_DATA 读请求边沿到来时置位 pop_pending。
      // bus_read 任务会把 req_valid 保持两拍；如果按电平触发，单次读会误 pop 多次。
      pop_pending <= (req_valid && !req_write && (addr_offset == REG_OUT_DATA) &&
                      !out_fifo_empty && !out_data_read_seen);
      out_data_read_seen <= (req_valid && !req_write && (addr_offset == REG_OUT_DATA));
    end
  end

  // -----------------------------------------------------------------------
  // 寄存器读回（纯组合逻辑，无流水线）
  //
  // 所有只读寄存器（NUM_INPUTS, NUM_OUTPUTS, STATUS 等）均为组合读出，
  // 与总线请求同拍返回 rdata（bus_interconnect 支持 1 cycle 响应）。
  //
  // REG_ADC_SAT_COUNT 字段布局：
  //   rdata = {adc_sat_low, adc_sat_high}
  //   → rdata[31:16] = adc_sat_low  （低饱和计数，放在高 16 位）
  //   → rdata[15:0]  = adc_sat_high （高饱和计数，放在低 16 位）
  //   注意：这个打包顺序看起来反直觉（"low"在高位），但这是设计选择，
  //         固件读取时需按此顺序解析（参见 top_tb.sv 的读取示例）。
  //
  // REG_CIM_TEST 字段布局：
  //   rdata = {8'h0, cim_test_data_neg[7:0], cim_test_data_pos[7:0], 7'h0, cim_test_mode}
  //   → bit[23:16] = cim_test_data_neg（负通道合成值，ch 10~19）
  //   → bit[15:8]  = cim_test_data_pos（正通道合成值，ch 0~9）
  //   → bit[0]     = cim_test_mode
  //
  // REG_DBG_CNT_0 字段布局：
  //   rdata = {dbg_cim_cycle_cnt[31:16], dbg_dma_frame_cnt[15:0]}
  //   → bit[31:16] = cim_cycle_cnt
  //   → bit[15:0]  = dma_frame_cnt
  // -----------------------------------------------------------------------
  // 状态寄存器组合逻辑
  always_comb begin
    rdata = 32'h0;
    case (addr_offset)
      REG_THRESHOLD:   rdata = neuron_threshold;                    // 读回当前阈值
      REG_TIMESTEPS:   rdata = {24'h0, timesteps};                  // 高 24 位填 0
      REG_NUM_INPUTS:  rdata = {16'h0, NUM_INPUTS[15:0]};           // 只读参数：=64
      REG_NUM_OUTPUTS: rdata = {24'h0, NUM_OUTPUTS[7:0]};           // 只读参数：=10
      REG_RESET_MODE:  rdata = {31'h0, reset_mode};                 // 高 31 位填 0
      REG_CIM_CTRL: begin
        rdata = 32'h0;
        rdata[7] = done_sticky; // bit[7]: DONE（W1C sticky，硬件完成后为 1）
        // bit[0]/bit[1] START/SOFT_RESET 为 W1P，读回固定为 0（脉冲只有 1 拍，读时已清零）
      end
      REG_STATUS: begin
        rdata[0]   = snn_busy;          // SNN 推理进行中
        rdata[1]   = in_fifo_empty;     // 输入 FIFO 空
        rdata[2]   = in_fifo_full;      // 输入 FIFO 满
        rdata[3]   = out_fifo_empty;    // 输出 FIFO 空
        rdata[4]   = out_fifo_full;     // 输出 FIFO 满
        rdata[15:8]= timestep_counter;  // 当前时步（0 ~ timesteps-1）
      end
      REG_OUT_DATA: begin
        // 若 FIFO 空，返回 0（不触发 pop）；否则返回 fall-through 队头
        // pop_pending 机制确保下一拍才弹出，本拍读到的值有效
        if (out_fifo_empty) begin
          rdata = 32'h0;
        end else begin
          rdata = {{(32-4){1'b0}}, out_fifo_rdata}; // 高 28 位填 0，低 4 位 = spike_id
        end
      end
      REG_OUT_COUNT: rdata = {{(32-$clog2(snn_soc_pkg::OUTPUT_FIFO_DEPTH+1)){1'b0}}, out_fifo_count}; // entry 数
      REG_THRESHOLD_RATIO: rdata = {24'h0, threshold_ratio}; // 高 24 位填 0，低 8 位 = ratio
      // ADC 饱和计数：sat_low 在高 16 位，sat_high 在低 16 位（见顶部注释）
      REG_ADC_SAT_COUNT:   rdata = {adc_sat_low, adc_sat_high};
      // CIM Test 寄存器：bit[23:16]=test_data_neg, bit[15:8]=test_data_pos, bit[0]=test_mode
      REG_CIM_TEST:        rdata = {8'h0, cim_test_data_neg, cim_test_data_pos, 7'h0, cim_test_mode};
      // Debug 计数器 0：高 16=cim_cycle，低 16=dma_frame
      REG_DBG_CNT_0:       rdata = {dbg_cim_cycle_cnt, dbg_dma_frame_cnt};
      // Debug 计数器 1：高 16=wl_stall，低 16=spike
      REG_DBG_CNT_1:       rdata = {dbg_wl_stall_cnt, dbg_spike_cnt};
      // CIM 编程寄存器
      // REG_PROG_CTRL readback layout:
      //   [0]=START (W1P, reads 0), [1]=ERASE, [2]=FULL_ARRAY, [3]=BYPASS_HANDSHAKE,
      //   [7:4]=LEVEL, [10:8]=RETRY_LIMIT, [31:11]=RAZ
      REG_PROG_CTRL:       rdata = {21'h0, prog_retry_limit, prog_level,
                                     prog_handshake_bypass, prog_full_array, prog_erase, 1'b0};
      REG_PROG_ROW:        rdata = {26'h0, prog_row};
      REG_PROG_COL:        rdata = {27'h0, prog_col};
      // PROG_STATUS readback layout:
      //   [0]   = BUSY (RO)
      //   [1]   = PASS (RO)
      //   [2]   = FAIL (RO)
      //   [5:3] = RETRY_COUNT (RO)
      //   [6]   = PROG_FSM_PRESENT (RO) — 1 表示 ENABLE_PROGRAM_MODE=1，cim_program_ctrl
      //           已实例化；0 表示编程 FSM 未实现（reg_bank 仍可读写但 START 不会生效）。
      //           固件用此位代替"探测 BUSY 升起"的 cycle-bound probe。
      //   [7]   = DONE (W1C sticky)
      REG_PROG_STATUS:     rdata = {24'h0, prog_done_sticky, ENABLE_PROGRAM_MODE,
                                     prog_retry_count, prog_fail, prog_pass, prog_busy};
      REG_PROG_PULSE_WIDTH: rdata = {14'h0, prog_write_pulse_sel, prog_pulse_width};
      REG_PROG_ERASE_WIDTH: rdata = {16'h0, prog_erase_width};
      default:        rdata = 32'h0; // 未映射地址读回 0
    endcase
  end
endmodule
