kira11-hash/snn-soc/(commit log)

2026-01-19 增加了项目文档，里面包含了接口、怎么学、计划
2026-02-25 verson -2.25 new
    [I-V.xlsx, SoC_论文问题统计.xlsx, exhaustive_64dim_schemeB_full.csv]
2026-02-26 spike or membrane
    [exhaustive_64dim_schemeB_full.csv]
2026-02-27 finished modeling
    [exhaustive_64dim_schemeB_full.csv]
2026-03-01 docs: add SPI long-read risk and mitigation strategy
2026-03-01 docs: add FPGA paper plan with codex review fixes
    新增 doc/13_fpga_paper_plan.md：
    - CIM macro FPGA 替代方案（数字 MAC + 器件非理想注入）
    - 论文定位、结构、MVP 数据需求、时间线
    - 与 ASIC 主线的关系及迭代路径
    codex 审查后修正 4 项：
    - 准确标注各 feature 分支当前状态（IP 独立验证通过 vs 顶层集成）
    - 引用标签闭合（D1-D5/A3/J1-J3 出处清单）
    - 数据流口径修正为 SPI→CPU→SRAM→DMA（非直连）
    - "零改动"改为"核心计算链路零改动"+明确板级适配层
2026-03-02 sync default to T=3 and refresh full-run artifacts/docs
    [exhaustive_64dim_schemeB_full.csv]
2026-03-02 docs: fix T=10→T=3 default across all docs + fix encoding
    - CLAUDE.md: TIMESTEPS=3, THRESHOLD_DEFAULT=3060, clean UTF-8 encoding
    - doc/11: all T=10/10200 references updated to T=3/3060 (6 places)
    - SNNSoC工程主文档: batch T=10→T=3 fix (16 replacements)
    - top_tb.sv: comment line 25 "=10" → "=3"
    - sim/icarus_light.out: refreshed with T=3 (CIM done 1418 polls, 90μs)
    Engineering default is now T=3 everywhere (RTL + TB + docs).
    T=10 retained only as paper high-accuracy reference point.
    [top_tb.sv]
2026-03-02 docs(repo): unify SPI progress status across docs + enforce LF for .sh
2026-03-02 docs(history): annotate UART/SPI stub sections with 2026-03-02 branch progress
2026-03-04 rtl(tb): sync robustness fixes (wstrb + light smoke assertions)
    [dma_engine.sv, reg_bank.sv, top_tb_icarus_light.sv]
2026-03-04 sim(tb,docs): fix light smoke pass/fail gating and clean mojibake text
    [top_tb_icarus_light.sv]
2026-03-09 feat(model): clean modeling flow and add weighted verification
    [exhaustive_64dim_schemeB_full.csv]
2026-03-14 Sync current main workspace
2026-03-14 Tighten smoke flows and sync default docs
    [top_tb.sv]
2026-03-15 feat(step3.4): add Python-RTL alignment scripts and stimulus files
    - export_expected_spike_ids.py: RTL-equivalent integer SNN inference
    using weight_pos/neg.hex level indices, matching scale_sum_to_adc
    exactly; exports all_samples.hex + expected_classes.hex for TB
    - top_tb_sample_align.sv: 10-sample alignment TB with spike histogram,
    argmax, and auto-compare vs expected_classes.hex
    - sim_sample_align.f / run_sample_align.sh: Icarus flow for alignment
    - all_samples.hex / expected_classes.hex: pre-generated stimulus
    (9/10 correct vs true label; sample[5] predicts 6 not 5 — by design)
    - doc/09_smoke_test_checklist.md: complete rewrite (Chinese, waveform
    guidance, Windows/Icarus vs L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
    [export_expected_spike_ids.py, top_tb_sample_align.sv]
2026-03-15 fix(sim): correct sample alignment fifo pop and batch support
    [reg_bank.sv, top_tb_sample_align.sv]
2026-03-15 fix(sim): stabilize weighted and sample-align input discovery
2026-03-16 Formalize 100-sample alignment corpus and ASIC pad map
2026-03-16 Clarify current-study guidance in learning path
2026-03-17 Refresh overview for current ASIC mainline
2026-03-18 Refine docs/comments and add ADC saturation regression
2026-03-18 feat(uart): integrate tx controller and tests
2026-03-18 feat(spi): integrate master controller and tests
2026-03-18 feat(dma): add multi-destination transfer modes
2026-03-18 docs(dma): sync dst selection register docs
2026-03-19 feat(e203): add spi boot flow and sync docs
2026-03-19 fix(top): wire chip-level cim path and enable e203
    [chip_top.sv, e203_tb.sv, snn_soc_top.sv, top_tb.sv, top_tb_adc_sat_counter.sv, top_tb_icarus_light.sv, top_tb_icarus_weighted.sv, top_tb_sample_align.sv]
2026-03-20 Add rescue JTAG loader and validation flow
2026-03-20 chore(main): tighten audit docs and firmware register defs
    [boot_main.c, jtag_rescue_main.c, main.c, soc_regs.h]
2026-03-21 chore(main): tapeout audit fixes — CDC attrs, lint, fw completeness, docs
    RTL:
    - jtag_mem_loader.sv: add (* async_reg = "TRUE" *) on all 6 CDC
    synchronizer FFs (3 paths × 2 FFs) for synthesis placement
    - reg_bank.sv: fix _unused wire — remove req_wstrb[3] which IS used
    for threshold byte3 write
    Firmware:
    - soc_regs.h: add missing REG_NUM_INPUTS (0x08), REG_NUM_OUTPUTS
    (0x0C), UART_RXDATA (0x04) register defines
    - main.c: explicitly set DMA_DST_SEL = DMA_DST_INPUT_FIFO before
    DMA start (was relying on reset default)
    Documentation:
    - doc/03: mark adc_start/adc_done as internal-simulation-only signals
    - doc/06: fix stale LIF_MEM_WIDTH description and DMA even-length
    constraint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
    [jtag_mem_loader.sv, main.c, reg_bank.sv, soc_regs.h]
2026-03-21 docs(audit): sync main status docs with verified flows
2026-03-21 chore(audit): tapeout pre-TO full audit — docs refined
    4-agent parallel audit (RTL params, docs, TB/sim, chip_top integration):
    - RTL: all 28 files pass — params, widths, signed arith, addr decode OK
    - chip_top: 39 signal pads, port directions, E203/CIM gating all verified
    - TB/sim: all pass criteria, filelists, timeouts verified correct
    - ADC sat counter TB confirmed correct (0xFF is intentional for saturation)
    Documentation refinements:
    - doc/02: ADC_SAT_COUNT explicit clearing semantics (START pulse clears)
    - doc/04: added RESET_MODE config footnote (soft/hard)
    - doc/07: added historical-plan disclaimer header, updated timestamps
    - doc/09: added parameter coverage matrix for bring-up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
2026-03-21 chore(audit): pre-TO full audit — docs refined, TB addresses parameterized
    - doc/00_overview: add missing JTAG test results (MEM_LOADER/RESCUE_TOP/PYHOST)
    - doc/07_tapeout_schedule: update V1 vs MVP status table (all items now ✅)
    - doc/06_learning_path: update Part B with actual V1 implementation references,
    fix E203 architecture (ICB→simple direct bridge, not AXI double-bridge),
    add DMA multi-target + JTAG rescue section (阶段 14)
    - tb/top_tb.sv: replace all hardcoded addresses with ADDR_*_BASE pkg constants
    Full audit scope: parameter consistency (OK), chip_top↔pad_map (39 pins match),
    RTL synthesis readiness (no blocking issues), register map alignment (OK).
    Co-Authored-By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
    [top_tb.sv]
2026-03-21 fix(audit): scope UART baud override to sim builds
    [soc_regs.h]
2026-03-22 fix(audit): harden JTAG rescue + SPI timing + doc DMA FSM
    - jtag_mem_loader: add 1023-cycle CLK-side timeout in WAIT_GRANT and
    WAIT_RSP states to prevent bus hang from permanently wedging the
    rescue module
    - spi_ctrl: fix last SCK high phase truncation — previously SCK was
    high for only 1 sysclk at bit_idx==7; now stays high for a full
    half-period before transitioning to ST_DONE (proper Mode 0 compliance)
    - doc/06: add multi-target DMA FSM paths (DST_WEIGHT_BUF/DST_INSTR_SRAM)
    alongside existing DST_INPUT_FIFO diagram; clarify even-length constraint
    [jtag_mem_loader.sv, spi_ctrl.sv]
2026-03-30 fix(audit): keep wl wrapper busy through done
    [wl_mux_wrapper.sv]
2026-04-17 docs: add work principles, false-positive KB, and paper writing guidelines
    Add stuck-handling workflow, decision framework, and RTL bug reporting
    rules to CLAUDE.md. Add paper prompt doc index and V1/V2 writing
    guidelines to README.md and doc/00_overview.md.
2026-04-21 main: port CIM write/erase/verify from v2 (single-layer 64->10 tapeout + programmable)
    【What this commit adds】
    main was inference-only (V1 frozen tapeout version). This commit ports the
    CIM programming / erase / verify subsystem (A) from v2 branch, keeping main
    purely single-layer (NUM_INPUTS=64 / ADC_CHANNELS=20 / Scheme B 20-ch differential).
    V2.B multi-layer refactor (256x256 array, streamed rate, stage_engine_v2, etc.)
    is intentionally NOT ported.
    【New RTL modules (copied from v2 verbatim)】
    - rtl/snn/cim_program_ctrl.sv (330 lines, 11-state FSM: IDLE->SETUP->PULSE->
    PULSE_HOLD->READBACK->RB_WAIT->VERIFY->{PASS|RETRY|FAIL}->DONE)
    - rtl/snn/cim_macro_arbiter.sv (110 lines, re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
    [cim_macro_arbiter.sv, cim_macro_blackbox.sv, cim_macro_blackbox_weighted_icarus.sv, cim_program_ctrl.sv, cim_program_ctrl_tb.sv, prog_pulse_cfg_tb.sv, reg_bank.sv, snn_soc_pkg.sv]
2026-04-22 main: fixup CIM programming port — Q2 back-to-back START interlock + Q5 zero-replicate
    GPT code review (2026-04-22) returned ❌ BLOCK with two must-fix items
    on prior commit 4540f788. This commit resolves both and adds a dedicated
    regression TB proving the race is closed.
    【Q2 FIX】reg_bank.sv: back-to-back START race
    Original guard was just `!snn_busy` / `!prog_busy`. But start_pulse W1P
    is observable at cycle N+1 while downstream FSM does not raise busy until
    cycle N+2 (single-cycle pipeline delay). CPU writing the opposite path's
    START in cycle N+1 would bypass the interlock — both FSMs entered busy,
    arbiter would hand CIM to prog (prog_busy=1), inference gets starved mid-flight.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
    [cim_program_ctrl.sv, prog_start_interlock_tb.sv, reg_bank.sv]
2026-04-22 main: fixup CIM programming port — Q1 sel clamp + Q4 split weight-model param + Q6 weight_mem reset 0
    GPT review round-2 (post 75f9b1ff) had 3 acceptable_with_comment items
    that user asked to also clean up. This commit addresses all three so
    no GPT non-blocking comments remain on the main port.
    【Q1】 reg_bank.sv: readback field-consistency clamp
    When firmware writes REG_PROG_PULSE_WIDTH with sel=2'd3 (reserved),
    decode_write_pulse_width already clamps width to 100us (the strongest
    valid SET pulse — deliberate safety guard against 1ms erase-width-sized
    SET pulses damaging RRAM cells). However the prior implementation
    stored the raw sel=3 into prog_write_pulse_sel, so readback returned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
    [cim_macro_blackbox.sv, prog_pulse_cfg_tb.sv, reg_bank.sv, snn_soc_top.sv]
2026-04-22 main: post-audit cleanup — MAIN-01 arbiter infer-side routing + MAIN-02 doc interlock
    2026-04-22 dual-line audit (APPROVE_WITH_MINOR_FIX) identified two non-blocking
    items on main; this commit closes both.
    【MAIN-01】rtl/top/snn_soc_top.sv — arbiter infer-side feedback path connected
    Prior to this fix, `cim_done` / `adc_done` / `bl_data` MUXes (line 1240-1248)
    consumed `*_hw` directly from `cim_macro_blackbox`, bypassing the registered
    arbiter outputs `arb_cim_done` / `arb_adc_done` / `arb_bl_data`. The arbiter
    masked inference→macro commands during `prog_busy=1`, but the macro→inference
    feedback path was NOT masked — a subtle asymmetric half-arbiter.
    No functional failure occu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
    [snn_soc_top.sv]
2026-04-23 feat(rtl+xdc): Stage 1+2 — critical warnings fixed + test_mode extended
    Stage 1: two CRITICAL WARNINGs fixed
    * constraints_e203.xdc:57 — set_false_path targeted a wire
    (*mmcm_locked*), Vivado silently ignored it. Retarget to the SINK
    side (rst_sync_reg[0]) which is an actual flop cell.
    * rtl/periph/uart_ctrl.sv:88 — baud_div_active was driven from two
    separate always_ff blocks, violating SV always_ff and causing Vivado
    to infer duplicate FFs with mixed GND/FF drivers (bit15..10/8/6/5/
    3/2/0 were hardwired to 0 because BAUD_DIV_DEFAULT=434 has those
    bits zero). Move baud_div_active ownership entirely into the TX
    FSM always_ff (reset + ST_IDLE latch in t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
    [reg_bank.sv, snn_soc_top.sv, uart_ctrl.sv]
2026-04-23 feat: Stage 3+4 — silicon bring-up firmware + Icarus TB
    Purpose: post-silicon digital-die self-test that exercises every
    digital RTL path in isolation, including when the separately-taped-out
    analog die is absent or broken.
    Firmware (fw/silicon_bringup/silicon_bringup.c):
    Stage A — inference with REG_CIM_TEST.test_mode=1 (pos=100, neg=0):
    pre-compute golden spike counts via SW LIF, compare against
    hardware histogram. Covers CPU → bus → reg_bank → DMA →
    cim_array_ctrl → adc_ctrl → test-mode MUX → LIF → OUT FIFO.
    Stage B — programming FSM with PROG_CTRL.BYPASS_HANDSHAKE=1:
    full-array erase then single-cell write at level=4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
    [silicon_bringup.c, silicon_bringup_tb.sv]
2026-04-23 feat: Stage 5 — add boot_rom mask ROM module (standalone + TB)
    Adds rtl/mem/boot_rom.sv, a foundation module for post-silicon boot.
    On ASIC tape-out, this is the mandatory replacement for the SRAM-based
    u_instr_sram at reset vector 0x0, because foundry SRAM macros generally
    do NOT support $readmemh preload — CPU fetching from uninitialized SRAM
    would fetch garbage and fault.
    Module design:
    * parameter SIZE_BYTES (default 4 KB)
    * parameter INIT_FILE ($readmemh image; empty → all zeros)
    * bus_simple_if compatible, read-only (writes ignored)
    * Combinational read (0-cycle latency, matches sram_simple protocol)
    * FPGA synthesis: inferred as distributed ROM / LUT-ROM for smal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
    [boot_rom.sv, boot_rom_tb.sv]
2026-04-23 feat+docs: Stage 6+8 — FPGA bring-up capture harness + silicon plan
    Stage 6: scripts/fpga_bringup_capture.sh
    Portable xsct + pyserial harness that
    1. programs the PL via xsct (re-uses scripts/program_zcu102_e203.tcl)
    2. opens the host's serial port (default COM3 = CP2108 Interface 2)
    3. streams UART bytes to a timestamped log under doc/main-fpga-e203/
    4. waits for a list of --tag strings with --timeout seconds bound
    5. aborts early on any --fail-tag match
    Exit codes: 0=all tags seen, 1=timeout missing, 2=fail tag, 3=xsct,
    4=serial open. Works on both Windows Git Bash and Linux
    (pyserial handles COM3 / /dev/ttyUSBn uniformly).
    Stage 8: d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
2026-04-23 gpt-fix: harden silicon bring-up bypass and capture flow
    [boot_rom.sv, boot_rom_tb.sv, prog_pulse_cfg_tb.sv, reg_bank.sv, silicon_bringup.c, silicon_bringup_tb.sv, snn_soc_top.sv, uart_tb.sv]
2026-04-23 gpt-fix: finalize main tapeout boot chain and ROM smoke
    [boot_rom_main.c, build_flash_image.py, chip_top.sv, chip_top_rom_smoke_tb.sv, prog_bypass_latch_tb.sv, rom_smoke_app.c]
2026-04-23 fix: review-driven tape-out blocker fixes (RTL CRIT-1..3 + MAJOR-1 + doc CRIT)
    Findings came from a 3-round exhaustive review (RTL / FW+build / docs) run
    on top of the Iteration 10 bring-up work. Only BLOCKERS are fixed here —
    remaining MINORs are left for the follow-up pass.
    ## RTL CRIT-1/2/3 — bridges reject ENABLE_BOOT_ROM-shifted INSTR_SRAM
    Three bridge modules (icb2simple_bridge / jtag_mem_loader / axi2simple_bridge)
    had an is_sram_addr() filter that only accepted ADDR_INSTR_BASE..ADDR_INSTR_END
    (0x0..0x3FFF). When chip_top sets ENABLE_BOOT_ROM=1 the real INSTR_SRAM is at
    0x1000..0x4FFF — the high 4 KB (0x4000..0x4FFF) was being pre-rejected as an
    illegal access, turning it un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
    [axi2simple_bridge.sv, icb2simple_bridge.sv, jtag_mem_loader.sv, reg_bank.sv]
2026-04-23 gpt-fix: prove high boot-rom instruction window and sync docs
    [axi_instr_hi_window_tb.sv, chip_top_hi_tb.sv, jtag_instr_hi_window_tb.sv, rom_smoke_app.c, silicon_bringup.c]
2026-04-23 feat(A8/rtl+docs): freeze external programming contract as scheme α' — 7 new pads (48→55)
    Context: Until today the analog CIM macro designer could not implement the external
    erase/write/verify path from documentation alone — doc/17 explicitly called A8
    ("how programming op-type / level / full-array semantics cross the chip boundary")
    out as a blocker. User decision today: scheme α' (add 7 dedicated D→A pads, keep
    all analog→digital pass/fail logic inside the digital die by reusing bl_data for
    readback).
    ## RTL
    rtl/top/snn_soc_top.sv:
    * New outputs prog_op_ext[2:0] + prog_level_ext[3:0] on the external CIM
    interface (guarded under ENABLE_EXT_CIM_IF; zero-effort when the p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
    [chip_top.sv, e203_tb.sv, jtag_rescue_top_tb.sv, prog_bypass_latch_tb.sv, silicon_bringup_tb.sv, snn_soc_top.sv, top_tb.sv, top_tb_adc_sat_counter.sv]
2026-04-23 feat(rtl+tb): close the two gaps behind scheme α' external programming
    Background: yesterday's 58408ca4 froze the 7 new external programming pads
    (prog_op[2:0] + prog_level[3:0]) and updated all analog-handoff docs. Two
    remaining gaps would have made the pad contract look correct on paper but
    not actually work when a real silicon chip_top pair is brought up:
    1) The new prog_op encoder had no assertion-style TB — we relied on static
    code review to say the encoder output matched cim_program_ctrl's FSM.
    2) wl_mux_wrapper was always driven by cim_array_ctrl's inference bitmap.
    When prog_busy=1 the analog macro saw the stale inference vector on
    wl_data_ext pads instead of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
    [prog_pad_encoder_tb.sv, prog_wl_pad_route_tb.sv, snn_soc_top.sv]
2026-04-23 fix(rtl+docs): scheme alpha' Q1/Q2/Q3 lock-in — cim_start gate semantics + prog_op pipeline alignment + verify timing/noise budget
    Q1 — cim_start_ext is now a LEVEL-hold gate (not a 1-cycle strobe) during
    prog_busy=1. The analog die holds programming/read voltage while cim_start=1
    and withdraws it on the falling edge. No analog-side self-timing is needed.
    Internal gate = (prog_dac_valid_sig | verify_en_sig_dly1), delayed by
    WL_MUX_LATENCY_CYC=10 cycles so the WL TDM burst on wl_data/wl_latch pads
    completes before the analog macro sees cim_start rise. A 1-cycle-delayed
    verify_en produces a guaranteed gate gap between the write pulse window and
    the verify readback window, during which prog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
    [prog_pad_encoder_tb.sv, prog_wl_pad_route_tb.sv, snn_soc_top.sv]
2026-04-23 gpt-fix(Q1Q2Q3-review): clarify external programming timing and noise contract
    [chip_top.sv]
2026-04-23 docs(handoff): record already-known device params (HRS/LRS/Vread/on-off/level encoding)
    A6 section: inline the pre-existing device parameters that came from I-V
    measurements + memristor_plugin.py fitting — Vread=1.5 V, on/off=5000:1,
    HRS≈1TΩ, LRS≈200MΩ, single-cell LRS theoretical I≈7.5 nA. Analog team no
    longer needs to re-answer these; they only need A6-1..A6-8 noise/dynamic-
    range quantitative numbers.
    A8 section: add A8-6 capturing the 16-level encoding method (multi-pulse,
    not multi-amplitude) which was confirmed by the device team. Residual open
    items for device side: SET pulse width adequacy (1/10/100 us presets) and
    retry limit default (3, max 7).
    Status table: A6 row upd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
2026-04-23 docs(handoff): mark pulse widths + retry limits as device-side confirmed
    A8-7: single SET pulse width tiers 1/10/100 us confirmed adequate by
    device professor (2026-04-24). pkg PROG_WRITE_PULSE_{1,10,100}US_CYC
    remain unchanged.
    A8-8: PROG_CTRL.RETRY_LIMIT default=3 / max=7 confirmed sufficient.
    pkg VERIFY_RETRY_MAX=7 remains unchanged.
    A8-9 / P2-1: RRAM power-on initial state still pending device teacher's
    reply. Bring-up firmware will default to running prog_op=100 full-array
    erase on boot as fail-safe; can skip if confirmed default-HRS later.
    A6 preamble: add the confirmed pulse/retry budget alongside the existing
    known device params (HRS/LRS/Vread/on-off) so the analog handoff has one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
2026-04-23 docs(handoff): add P0 blocker quick-index for analog side (18 items)
    Place the 18 analog-side items that actually block digital backend STA
    signoff at the top of doc/11, right after the 2026-04-24 status update
    block. Each entry cites the corresponding A4/A5/A6/A7/P0/P1 section
    and explains what the digital side uses that parameter for, so the
    analog professor can prioritize them over the rest.
    Device-side items are NOT in this P0 list because:
    - A8-7 / A8-8 (pulse widths + retry limits) already confirmed OK
    - P2-1 (RRAM power-on state) already queried, awaiting reply
    Recommended reply deadline: 2026-05-08 (2 weeks).
2026-04-24 fw(main): add boot-time RRAM full-array erase (P2-1 closed)
    Device team confirmed on 2026-04-24 that RRAM cells after tape-out are
    not guaranteed to start in HRS, so the production boot flow must run a
    full-array erase before any inference or weight programming.
    New boot_full_array_erase() helper in fw/main.c:
    1. Issues PROG_CTRL = ERASE | FULL_ARRAY | START (BYPASS_HANDSHAKE=0 so
    the real analog die receives the 1 ms RESET pulse).
    2. Probes PROG_STATUS.BUSY for BOOT_ERASE_PROBE_CYCLES=256 loop iters.
    If BUSY never rises, the build has ENABLE_PROGRAM_MODE=0 (FSM tied
    off) and we skip silently; returns 2u.
    3. Otherwise polls PROG_STATUS.DONE up to BOOT_ERASE_POLL_TIMEOUT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
    [main.c]
2026-04-24 fw+tb: make boot-time erase work in e203 regression
    fw/main.c
    hist[10]={0} compiled to memset under -nostdlib + riscv64-unknown-elf-gcc
    13.2, replaced with explicit for-loop zero fill.
    tb/e203_tb.sv
    - ENABLE_PROGRAM_MODE=1 aligned with chip_top and silicon_bringup_tb.
    Required because fw/main.c writes PROG_CTRL.START at boot; reg_bank
    prog_start_pending interlock would permanently latch when FSM absent
    (prog_busy tied 0 never clears pending), which blocks CIM_CTRL.START.
    - ENABLE_PROGRAM_WEIGHT_MODEL=0 pinned so cim_macro_blackbox stays on
    popcount behavior model. Default follows ENABLE_PROGRAM_MODE (=1),
    which switches to BRAM weight_mem, but boot erase zeros th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
    [e203_tb.sv, main.c]
2026-04-24 docs: analyze why fw/main.c boot erase does not need FPGA re-validation
    New doc/main-fpga-e203/fw_main_c_boot_erase_board_validation_analysis.md
    explains the two independent firmware paths in the project:
    fw/main.c -> tape-out silicon SPI-flash boot chain (just
    added full-array erase in e56c7c05)
    fw/e203_smoke/
    e203_fpga_smoke.c -> FPGA ZCU102 bitstream BRAM pre-init
    (ALREADY does full-array erase in Phase 1
    Step 1a; alpha-passed tag validates it)
    The device team request from 2026-04-24 (RRAM must erase on boot) is
    therefore already satisfied on the FPGA path by the alpha-passed boa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
2026-04-24 gpt-fix(boot-erase-review): harden boot erase and disabled prog interlock
    [e203_tb.sv, main.c, prog_disabled_no_pending_tb.sv, reg_bank.sv, snn_soc_top.sv]
2026-04-25 fix(rtl/fw): in-flight prog reg lock + RETRY_LIMIT preserve + boot_rom OOB
    - reg_bank: PROG_CTRL config fields (ERASE/FULL_ARRAY/BYPASS/LEVEL/RETRY_LIMIT)
    + PROG_ROW + PROG_COL + PROG_PULSE_WIDTH writes blocked while
    prog_busy / prog_start_pending / prog_start_pulse, preventing 10-stage pad
    pipeline divergence vs cim_program_ctrl latched values. PROG_STATUS adds
    bit 6 = PROG_FSM_PRESENT (RO, ENABLE_PROGRAM_MODE).
    - fw/main.c: replace 256-cycle BUSY probe with PROG_STATUS[6] check (race-free
    vs future fast pulses). PROG_CTRL write changed to read-modify-write so
    RETRY_LIMIT default (4) is no longer silently zeroed. erase return-code
    semantics tightened to "controller SEQ_DONE" (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
    [axi2simple_bridge.sv, boot_rom.sv, chip_top.sv, icb2simple_bridge.sv, jtag_mem_loader.sv, main.c, reg_bank.sv, snn_soc_top.sv]
2026-04-25 test: prog_inflight_lock + boot_erase_e2e regressions + tb param wiring
    - prog_inflight_lock_tb (NEW): 18 sub-tests verifying reg_bank silently
    ignores config writes to PROG_CTRL/ROW/COL/PULSE_WIDTH while
    prog_busy=1, then accepts again after FSM returns to IDLE.
    - boot_erase_e2e_tb (NEW): seeds 1280 cells with 0x40, runs fw boot
    full-array erase via PROG_STATUS[6]+START path, polls DONE, then
    reads back all 1280 cells and asserts == 0. Validates the integrated
    reg_bank + cim_program_ctrl + macro path end-to-end.
    - e203_tb: BOOT_POLLS_MAX / SIGN_POLLS_MAX defines (compile-time
    override) for future fw size growth instead of hardcoded constants.
    - axi_instr_hi_window_tb / jtag_inst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
2026-04-25 docs: 55-pad/RW-in-flight-lock/PROG_FSM_PRESENT/erase-SEQ_DONE semantics
    - doc/02_reg_map.md: mark all PROG_* config fields as RW^1 with footnote
    explaining in-flight write lock (prog_busy gating). Add PROG_STATUS[6]
    PROG_FSM_PRESENT row. Mark RETRY_LIMIT row with explicit
    read-modify-write requirement when whole-word writing PROG_CTRL.
    Reference tb/prog_inflight_lock_tb as coverage evidence.
    - doc/03/08/15/silicon_bringup_guide: refresh "45-pad" / "48-pad"
    language to current 55-pad package (pads 19..45 = inference carrier
    subset, full package per doc/15).
    - doc/15: prog_level pad description now explains the 10-stage shift
    register that phase-aligns with cim_start_ext, and th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
2026-04-25 docs(handoff): lock P0-6 IO voltage alignment — zero level shifter
    Confirmed with both digital and analog teams (2026-04-25):
    - Both PDKs use core 1.2V / IO 3.3V
    - Inter-chip digital signals stay 3.3V LVCMOS on both sides
    - No level shifter ICs needed on PCB (saves BOM + 5-10ns delay)
    - chip_top pad cells: 3.3V LVCMOS33 (drive/slew TBD with PDK)
    - Note: RRAM SET/RESET high-voltage is generated internally on analog
    die via charge pump, does not exit pad ring — orthogonal to interface
    voltage decision
    This closes a P0 risk item that was previously open (sidebar question
    during v2-arm-fpga-demo fix wave merge).
2026-04-25 fix(P0): align PROG_CTRL.RETRY_LIMIT documentation with RTL truth
    Pre-fix mismatch (Claude arm-audit F3, deferred to main as P0):
    RTL truth : PROG_VERIFY_RETRY_MAX = 4 (rtl/top/snn_soc_pkg.sv:221)
    reg_bank reset value <= 4 (rtl/reg/reg_bank.sv:353)
    field width 3-bit so SW upper bound is 7
    doc/02_reg_map : default=4 (already correct, no change)
    doc/08 : "默认 3，可配到 7" ← wrong default
    doc/11 : "默认 3 / 上限 7" ← wrong default
    doc/11 A8-8 : "pkg 参数 VERIFY_RETRY_MAX=7" ← outright wrong (pkg has 4)
    doc/17 : "默认 3 次，可配到 7 次" ← wrong default
    Root cause: P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
2026-04-25 gpt-fix(clock-reset-handoff): freeze PCB-shared clock reset ownership
2026-04-25 docs(handoff): add PCB Reference BOM reminder for clock+reset distribution
    Add a new "PCB Reference BOM (PCB 设计提醒)" section to doc/15 right
    between the Notes block and the Full 55-Pad Table. The section is meant
    as a hard reminder for the PCB designer doing schematic capture later:
    Clock distribution topology:
    PCB 50 MHz CMOS oscillator (50/50 nominal duty)
    -> wire -> digital die pad 01 'clk' (in)
    -> wire -> analog die 'clk_in' (in)
    Reset distribution topology:
    PCB supervisor IC (MAX809 / LM809 / TPS3839) + optional manual button
    -> wire -> digital die pad 02 'rst_n' (in)
    -> wire -> analog die 'rst_n' (in)
    Key invariants:
    - Digital and analog die share the sa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
2026-04-25 docs(handoff): remove P0-7/8/9/10 from digital-side P0 quick-index
    P0-7..P0-10 (PCB shared clock/reset distribution, analog DCC PVT range,
    reset deassert sync, PCB SI constraints) were mistakenly placed in the
    '数字侧 P0 阻塞项快速清单' (digital-side P0 blocker quick-index) at the
    top of doc/11. They are NOT actually digital-side STA signoff blockers:
    - P0-7 : analog team's internal pad list info (they know their own die)
    - P0-8 : analog die's internal DCC design choice + PVT spec
    - P0-9 : analog/board bring-up coordination, not chip STA
    - P0-10 : pure PCB designer concern
    The digital-side STA signoff blockers remain the original 18 items
    covering A4 (Vref/TIA), A5 (ti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
2026-04-25 docs(handoff): clarify safe reset button topology
2026-04-25 docs(handoff): add PCB mixed-signal integration best-practice checklist
    Add a new section "PCB 混合信号集成提醒（给画板同学的 best-practice 清单）"
    to doc/15 right after the existing "PCB Reference BOM" topology block.
    The new section is a 10-point checklist for the PCB designer covering:
    1. Power domain isolation (AVDD/DVDD independent LDO + ferrite bead +
    decoupling caps)
    2. Ground plane strategy (single plane preferred; split only with
    single-point connection)
    3. Clock trace handling (oscillator placement, controlled impedance,
    source-end termination, 3W spacing from analog sensitive lines,
    optional shield trace)
    4. Inter-die signal crosstalk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
2026-04-29 docs(06): refresh learning path with V1.1 Part C + minor stale comment fixes
    - doc/06_learning_path.md: extend with Part C "V1.1 Tape-out Hardening Layer"
    (Stages 15-18 covering boot_rom + chip_top tape-out wrapper, CIM programming
    mode + boot-time RRAM erase, scheme α' external programming pads, silicon
    bring-up firmware + FPGA evidence chain). Refresh banner with current main
    baseline (55-pad / 8.7K RTL / Iter 10-11 status). Last-updated date moved to
    2026-04-29.
    - rtl/snn/wl_mux_wrapper.sv: fix stale "48 pad budget" comment to point at
    current 55-pad freeze in doc/15 (no logic change).
    - tb/axi_bridge_tb.sv: clarify the T3 stub register write — value 0x0BF4 was
    arbitrary,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
    [axi_bridge_tb.sv, wl_mux_wrapper.sv]
2026-04-29 docs(audit): sync V1.1 review notes — no FPGA reburn needed
2026-04-29 docs(audit): fix alpha evidence link drift — no FPGA reburn needed
2026-04-29 docs(rtl): add interview-perspective comments to V1/V1.1 core modules — no FPGA reburn needed
    Adds first-person 设计者视角 comment blocks (cheat sheet + corner-case
    notes) to the 5 most asked-about modules to make code review and
    interview prep easier. Pure // comment additions — zero logic, port,
    or signal changes; LIGHT_SMOKETEST_PASS re-verified after edit.
    Files:
    - rtl/top/snn_soc_top.sv : SoC 顶层 cheat sheet + wl_mux 10-stage 对齐 + CIM Test Mode 讲解
    - rtl/reg/reg_bank.sv : W1P/W1C 语义 + V1.1 in-flight lock 讲解
    - rtl/snn/cim_program_ctrl.sv: 11-state FSM 设计动机 + verify ±2 窗口推导
    - rtl/snn/lif_neurons.sv : IF vs LIF 裁剪理由 + bit-p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
2026-04-29 docs(rtl): self-review fixes + inline comments at FP-误报 / bug-fix hotspots — no FPGA reburn needed
    Self-audit found 1 factual imprecision in earlier interview-comment
    commit (snn_soc_top wl_mux 10-cycle decomposition wording was sloppy).
    Fixed it and added inline comments at 3 specific FP-误报 / bug-fix
    hotspots that are likely to be deep-questioned in interview.
    Verification: LIGHT_SMOKETEST_PASS + E203_SMOKETEST_PASS +
    CIM_PROGRAM_CTRL_PASS all re-run after edits.
    - rtl/top/snn_soc_top.sv : tighten wl_mux 10-cycle latency wording (was "8+1+1" → 实际是 IDLE 锁存 + 8 SEND + DONE)
    - rtl/snn/lif_neurons.sv : add inline note at "<<<" line — FP-001 误报点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
    [cim_program_ctrl.sv, dma_engine.sv, lif_neurons.sv, snn_soc_top.sv]
2026-05-02 docs(iteration): record ARM timing and preload debug retrospective
2026-05-02 docs(iteration): expand ARM preload debug retrospective
2026-05-02 audit-pass(workspace): cleanup + extend .gitignore（pre-tape-out audit, 2026-05-02）
    清理 main 工作区噪音 + 扩展 .gitignore 防止跨支线泄漏：
    清理（已 rm 的本地噪音）：
    - nul（Windows 保留文件名 stray）
    - sim/v2b_partial_write_invariant_test（V2 audit 留下的 556KB iverilog vvp 二进制）
    - tb/conv_tile_e2e_tb.sv / sim/sim_conv_tile_e2e.f / sim/run_conv_tile_e2e.sh
    （V2 worker3 worktree 漂入物，引用 main 上不存在的 V2B_NUM_INPUTS / snn_soc_v2b_top）
    新增 .gitignore 段：
    - fw/arm/ — feature/v2-arm-fpga-demo-conv 编译产物
    - local_qa/, tests/ — 本地 QA 工具源 + 单测
    - requirement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
2026-05-02 audit-pass(rtl): BLOCKER B-1 + B-2 — chip_top default ROM + cim_program_ctrl verify window clamp
    pre-tape-out audit 抓出 2 个 RTL BLOCKER：
    B-1: chip_top BOOT_ROM_INIT_FILE 默认空 → ASIC 上电立刻 trap
    - 原默认 parameter BOOT_ROM_INIT_FILE = ""，依赖实例化时 override
    - 流片走 chip_top + ENABLE_BOOT_ROM=1，如忘记 override，foundry mask ROM
    compiler 拿到的就是全 0，CPU pc_rtvec=0x0 → 取到 32'h00000000 (RV32I 非法
    指令) → trap → silicon Day 1 第一关失败、UART 永不输出
    - 现有 initial $display 警告只在 sim 跑，synthesis/silicon 不会报
    - Fix: 默认改 "fw/boot_rom/out/boot_rom.hex"，让默认值就是合法 boot 镜像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
    [chip_top.sv, cim_program_ctrl.sv]
2026-05-02 audit-pass(tb,sim): BLOCKER B-01 + B-03 + silicon_bringup_tb FW-C1 follow-up TODO
    pre-tape-out audit 抓出 sim 守口 / TB 协议化 BLOCKER + 1 个 FW-side TODO：
    B-01: rtl_with_chip_top_check.f 缺 boot_rom + cim_macro_arbiter + cim_program_ctrl
    - chip_top 流片配置 ENABLE_PROGRAM_MODE=1 + ENABLE_BOOT_ROM=1，generate 块例化
    cim_program_ctrl + cim_macro_arbiter + boot_rom
    - 旧 filelist 漏掉这 3 个文件 → doc/09_smoke_test_checklist.md line 56-57 给出
    的 chip_top lint+编译命令在 main 上跑不起来（unknown module 报错）
    - 流片影响：chip_top 是 tape-out wrapper，没有 lint+编译门禁，PNR 网表 vs RTL
    一致性、pad 路由、mask ROM 接管 i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
2026-05-02 audit-pass(fw): BLOCKER B1 silicon_bringup link to 0x1000 + C4 hang() uart_wait_idle + hex rebuilt
    pre-tape-out audit 抓出 silicon bring-up firmware 最严重的 BLOCKER：硅片 Day 1
    JTAG rescue 烧固件会盲掉。
    B1: silicon_bringup ELF 链接基址 0x0 vs 操作手册 / chip_top 真实地址 0x1000
    - 旧 build_silicon_bringup.sh 用 -T fw/link.ld（IMEM ORIGIN=0x00000000）
    - 但流片 chip_top 配 ENABLE_BOOT_ROM=1，物理 INSTR_SRAM 基址被 mask ROM 占
    0..0xFFF 抢去，移到 0x1000；操作手册 doc/silicon_bringup_guide.md:115-118 +
    silicon_bringup_plan.md:124-127 + scripts/jtag_rescue.py:385-394 全部明指
    --load-addr 0x1000
    - 旧链接的 ELF 在硅片上：栈/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
2026-05-02 audit-pass(doc): BLOCKER B1+B2+B3 + CONCERN C1+C2 doc factual fixes
    pre-tape-out audit 抓出 5 个文档事实错误（其中 3 个 BLOCKER）：
    DOC-B1: doc/06_learning_path.md:1480 prog_op[2:0] 编码完全错（CRITICAL）
    - 原文写 100=full_array_erase / 101=erase_single / 110=write / 111=verify
    - 与 RTL 权威源（rtl/top/snn_soc_top.sv:1264-1268）相比：
    · 真实编码 001=erase_single / 010=write / 011=verify / 100=erase_full_array
    · doc/15_asic_pad_map.md:226-232 / doc/03_cim_if_protocol.md:67-75 /
    doc/17_cim_macro_handoff_cover.md:101-109 都和 RTL 一致
    · 只有 doc/06 单独错
    - 影响：模拟同学读 06 按 110=write 实现解码逻辑，硅片 PCB 集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
2026-05-02 audit-pass2(tb): FW-C1 follow-up — silicon_bringup_tb 切到 chip_top + stub ROM
    之前 audit 修了 FW B1（silicon_bringup link 0x0 → 0x1000）但 silicon_bringup_tb
    保持 snn_soc_top + ENABLE_BOOT_ROM=0，导致 hex 装到 instr_sram@0x0、PC=0x0
    开始执行，但代码编译时假定 PC=0x1000——栈/绝对地址全错位 → TB false-negative。
    本 commit 把 silicon_bringup_tb 切到与硅片一致的配置：
    - dut 改用 chip_top（之前是 snn_soc_top）
    - 用一份 stub boot_rom.hex（首字节 0x0100006F = jal x0,+0x1000，rest NOP）
    让 boot_rom 直接跳到 0x1000，跳过 SPI flash boot 流程
    - silicon_bringup.hex 装入 dut.u_soc_core.u_instr_sram.mem（chip_top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
2026-05-02 audit-pass2(tb): TB-C-01 — 5 个 top-level TB 加 global watchdog + FAIL marker
    pre-tape-out audit follow-up：之前 audit 抓出 5 个 top-level TB 没有 global
    timeout watchdog，RTL livelock 时 CI 会无声 hang，sample_align（流片开闸点）
    尤其危险。本 commit 全部补上。
    涉及 TB（按 timeout 量级）：
    - top_tb_icarus_light.sv: #5_000_000 (5 ms) — 黑盒 smoke
    - top_tb_icarus_weighted.sv: #20_000_000 (20 ms) — 带权重 + UART trace
    - top_tb_sample_align.sv: #100_000_000 (100 ms)— 100 sample × ~500us
    - top_tb_adc_sat_counter.sv: #5_000_000 (5 ms) — ADC 饱和计数
    - jtag_mem_loader_tb.sv: #2_000_000 (2 ms) —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
    [jtag_mem_loader_tb.sv, top_tb_adc_sat_counter.sv, top_tb_icarus_light.sv, top_tb_icarus_weighted.sv, top_tb_sample_align.sv]
2026-05-02 audit-pass2(rtl): R-M1 + R-M2 — uart/spi wstrb gate + dma fifo-full timeout
    pre-tape-out audit follow-up：
    R-M1: uart_ctrl + spi_ctrl 不检查 req_wstrb，byte-write 误清字段
    - 旧版 V1 外设忽略 wstrb 整字写；fw 用 byte-write 改 REG_TXDATA / REG_CTRL
    低字节会意外清掉高字节（例如修改 baud_div_reg[7:0] 不应清 [15:8]）
    - Fix uart_ctrl：REG_TXDATA 仅 wstrb[0] 命中才写；REG_CTRL 按 byte 选择性
    更新 baud_div_reg[7:0]/[15:8]
    - Fix spi_ctrl：REG_CTRL / REG_TXDATA 仅 wstrb[0] 命中才写或启动事务
    - 移除两个文件的 `_unused = req_wstrb` lint 抑制
    - Verify: run_uart_icarus → UART_SMOKETEST_PASS / run_spi_icarus → SPI_SMOKETES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
    [dma_engine.sv, snn_soc_pkg.sv, spi_ctrl.sv, uart_ctrl.sv]
2026-05-02 audit-pass2(fw,doc): FW-C2 + FW-C3 + DOC-C5 — V1 legacy banner + boot_rom golden track + schedule sync
    FW-C2: fw/build_e203_firmware.sh 是 V1 legacy 链 0x10000，不能用于 tape-out
    - 旧脚本顶部只有注释提示 "tape-out 用新链"，没有任何强制阻拦
    - 操作员误用 → app 链到 0x10000 → boot_rom_main.c app_range_ok() 直接 reject
    （ROM_APP_BASE/END = 0x1000..0x4FFF 不包含 0x10000）→ 卡 JTAG rescue
    - Fix: 顶部加 ⚠⚠⚠ FW-C2 audit warning 段说明硅片不兼容；脚本默认 set -e
    exit 1，要求显式设置 ALLOW_LEGACY_V1_FW=1 才继续
    - 配套：sim/run_e203_icarus.sh 加 ALLOW_LEGACY_V1_FW=1 让旧 sim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
2026-05-02 audit-pass2(doc): R-C9 — BYPASS_HANDSHAKE policy + production readback assert（无 efuse 决策）
    pre-tape-out audit follow-up：R-C9 之前标 "待你拍板"。用户确认本 die 工艺**不带
    efuse / OTP cell**，所以方案 A（硬件锁）不可行，**只能走方案 B（生产固件 readback
    assert）**。本 commit 把决策完整写进 silicon_bringup_plan.md 新增 §6。
    §6 新增内容：
    - 6.1 背景：为什么 BYPASS_HANDSHAKE 危险（reg_bank.sv 普通 RW bit，没硬件锁）
    - 6.2 R-C9 决策：本 die 不带 OTP，固定走方案 B（生产固件软件 lock）
    - 6.3 三阶段生命周期表：
    Day 1-2 数字自检 → BYPASS=1（必需，silicon_bringup.c 走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
2026-05-02 audit-pass2(doc): 落地 Claude + GPT cold-start audit prompts（main + main-fpga-e203-alpha 双支线终审）
    用户要求出 2 份 prompt：
    1. doc/Claude_audit_prompt_2026_05_02_main_and_fpga.md
    - 给一个新的 Claude 对话 / 新 session 用
    - 冷启动友好（含项目 30s 速览、目录布局、CLAUDE.md 必读、误报库 FP-001..FP-005、
    前一轮 audit 14 个 commit 清单、跨分支一致性硬约束）
    - 任务：审 main + main-fpga-e203-alpha，有问题直接改 + commit + push；
    不跑 FPGA 板验（GPT 那边的活）
    - deliverable：markdown 总结 + commit list + 跨分支 diff sanity
    2. doc/GPT_audit_prompt_2026_05_02_main_and_fpga.md
    -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
2026-05-02 docs(prompt): GPT audit prompt 加 §4.3.1 板验失败必须回流 main
    用户补充要求：如果 GPT 烧板验失败、为此修了项目，且根因是 main 也有的问题
    （不仅 FPGA-specific），那 fix 必须**双侧 commit**，不能只在 main-fpga-e203-alpha
    上 patch。
    新增 §4.3.1：板验失败处理流程
    - (a) 失败根因 FPGA-specific（仅在 fpga/ / fpga_synth/ / fw/e203_smoke/ 下）
    → 只在 FPGA 支线修
    - (b) 失败根因是 RTL / shared FW / shared sim / shared doc（main 也有）
    ☆☆☆ 必须双侧修：先 main commit + push origin main，
    再 FPGA worktree git pull + git merge main + push（fast-forward）
    最后跨分支 diff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
2026-05-02 audit-pass3(rtl,fw,doc): W-1 + R-M1.1 + D-1 — workspace cleanup + uart wstrb + doc macro fix
    第三轮 cold-start audit（pre-tape-out 严苛）抓的三组改动：
    W-1（workspace）：fw build artifact 跟踪策略一致化
    - W-1a: fw/silicon_bringup/out/silicon_bringup.bin 漏 git add（前一轮 FW-C3
    commit message 说"silicon_bringup 同样处理"，但实际只 track 了 .hex，没
    track .bin；与 boot_rom（.bin/.hex 都 tracked）风格不一致）。本轮 add
    进来。bin 与已 tracked 的 hex 字节完全对齐（前 3348 bytes match）。
    - W-1b: fw/boot_rom/out/rom_smoke_*.bin/.hex 与 rom_hi_smoke_*.bin/.hex 是
    chip_top_rom_smoke / chip_top_rom_hi_smoke TB 在 s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
    [uart_ctrl.sv]
2026-05-02 audit-pass3(doc): 落地 Claude audit pass 3 总结报告（evidence trail）
    第三轮 cold-start audit 的最终交付物，按 Claude_audit_prompt §六 模板写成：
    - BLOCKER：0 个新增（前一轮 9 个 BLOCKER 经本轮重审 fix 行为正确）
    - CONCERN：4 个全部已修 + push（W-1a / W-1b / R-M1.1 / D-1）
    - MINOR：4 个 follow-up 列出建议（M-1 __DATE__ reproducibility / M-2 PROG_*
    宏统一 / M-3 spi_ctrl byte-selective / M-4 DMA timeout 实测）
    跨分支 sanity 验证：
    - git diff origin/main vs origin/main-fpga-e203-alpha → 25 文件全部 FPGA-only ✓
    - main HEAD: bd78a0b0
    - main-fpga-e203-alpha HEAD: 7644dea9 (Merge branch 'main')
    sim regression（push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
2026-05-02 audit-pass4(fw,rtl,tb): M-1 + M-2 + M-3 — minor follow-ups from pass3
    M-1: silicon_bringup hex byte-reproducible by default. Replaced __DATE__
    embedding with SILICON_BRINGUP_BUILD_ID injected from
    build_silicon_bringup.sh. Default value is "frozen"; set SOURCE_DATE_EPOCH
    in the env to embed a real YYYY-MM-DD instead. Verified two consecutive
    rebuilds produce byte-identical .bin/.hex.
    M-2: PROG_* register aliases (PROG_CTRL/ROW/COL/STATUS/PULSE_WIDTH/
    ERASE_WIDTH and bit-field masks) centralized in fw/include/soc_regs.h.
    Deleted the duplicated copies in silicon_bringup.c and main.c. Moves the
    authoritative bit-field source out of three drift-prone fw files into one
    header. e203_fpga_smoke.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
    [main.c, silicon_bringup.c, soc_regs.h, spi_ctrl.sv, spi_tb.sv]
2026-05-02 docs(prompt): land Claude audit pass 5 cold-start prompt
    Captures audit-pass3/pass4 history (commits + fix categories), narrows
    the next-round scope to RTL/FW/TB/sim/doc with explicit corner cases
    that pass4 surfaced but did not chase (M-4 hardware timeout, M-5 build
    artifact churn, M-6 RMW comment), and sets the deliverable template
    matching pass3/pass4 reports. Used by the next Claude session to
    continue iterative pre-tape-out audit while GPT is occupied with FPGA
    board validation.
2026-05-02 audit-pass5(rtl,tb): R-M2.1 — clear push_stall_cnt at new-op entry + timeout exit + dma_tb T11
    DMA `push_stall_cnt` 在 ST_PUSH timeout 退出时未清零，下一次 START 进入
    ST_PUSH 时若 in_fifo_full 仍为 1，第 1 拍就触发假阳性 ERR，新事务未享受
    完整 timeout 窗口。已有清零路径只覆盖 (a) async reset 和 (b) ST_PUSH
    成功 push 分支。
    Fix（采纳 GPT-5.4 plan 审 + 终审 LGTM 的 Option C，defense-in-depth）：
    - rtl/dma/dma_engine.sv：
    * 新增 module 参数 PUSH_TIMEOUT_CYCLES（默认沿用 snn_soc_pkg::V2B_DMA_
    PUSH_TIMEOUT_CYCLES = 1M cycles）；snn_soc_top 不 override，硅片默认
    行为 100% 等价
    * ST_IDLE→ST_SETUP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
    [dma_engine.sv, dma_tb.sv]
2026-05-02 audit-pass5(doc): land Claude audit pass 5 report
    总结 pass5 cold-start audit 成果：
    - 1 个 CONCERN：R-M2.1（DMA push_stall_cnt timeout-exit 残留 → 假阳性 ERR）
    已在 e46069a6 修复 + 2aae56ef FPGA 同步
    - 4 个 MINOR follow-up（M-4 timeout 硅片实测 / M-5 e203_smoke .dump churn /
    M-6 fw/main.c LEVEL clear 注释 / M-7 spi_tb byte0+1 联写覆盖）
    - pass2~pass4 修复全部稳：M-1 (silicon_bringup BUILD_ID 字节级可重现) /
    M-2 (PROG_* 集中在 soc_regs.h，3 固件无残留) / M-3 (spi_ctrl byte-strobe) /
    D-2 (silicon_bringup_plan §6.4 NOTE) / R-C9 (BYPASS production assert) /
    prog_inflight lock / JTAG CDC / reg_bank byte-strobe 全覆盖
    - 8/8 核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
2026-05-02 docs(prompt): GPT audit prompt 加 pass3/4/5 commit list + 更新 verify 重点
    用户连续跑了 3 轮新的 Claude cold-start audit（pass3 / pass4 / pass5），
    共 8 个新 commits 已 push origin/main 和 origin/main-fpga-e203-alpha。
    GPT prompt 的 §二（Claude 已完成的 audit）原本只列了 pass1+pass2 的 14 个
    commits，现在补全到 5 轮：
    §二.Pass 3（bd78a0b0 + 0ac8f269）：
    W-1a: silicon_bringup.bin git track（与 boot_rom 一致）
    W-1b: rom_smoke_*/rom_hi_smoke_* gitignore
    R-M1.1: uart_ctrl ST_IDLE TX 启动路径补 wstrb[0] gate（旧 R-M1 漏路径）
    D-1: PROG_CTRL_BYPASS_MASK 宏一致性
    §二.Pass 4（3375d898 + 7495172b + 63bf8692）：
    M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
2026-05-02 docs(06): refine V1.1 stages 15-18 — pedagogy aids（学习方法 / 阅读顺序 / 面试追问 / worked example）
    main 分支 V1.1 加固层（boot ROM + chip_top + CIM 编程 + α' 外部接口 +
    silicon bring-up）原本是 reference 风格，没有 conv evidence 分支那种
    progressive pedagogy。本 commit 在保留所有原有内容的基础上，给 4 个 V1.1
    阶段加 pedagogy 辅助：
    阶段 15（boot ROM + chip_top）新增：
    - §15.0 学习方法（2 天节奏：鸟瞰 → 读源码 → 启动链 → 跑 sim）
    - §15.0.1 推荐阅读源码顺序（按依赖从下到上 8 个文件）
    阶段 16（CIM 编程模式 + boot-time 擦除）新增：
    - §16.0 学习方法（3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
2026-05-03 docs(audit): cold-start prompt for round 1 4-branch full audit
    Structured GPT-5.4 cold-start prompt to drive a multi-subagent audit pass
    across all four active branches (main, main-fpga-e203-alpha,
    feature/v2-arm-fpga-demo-conv, feature/v2-fpga-e203-conv).
    Key requirements baked into the prompt:
    - Mandatory parallel sub-agent spawn (>= 5 agents: RTL bug hunt, Python/RTL
    parity, doc cross-consistency, main vs main-fpga-e203-alpha sync, test
    infra integrity)
    - main vs main-fpga-e203-alpha must remain identical outside FPGA-specific
    files; any bug found in main must be flagged as needing sync to
    main-fpga-e203-alpha
    - Per-branch FPGA reburn decision table (YES/NO + reason + evidence fi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
2026-05-03 docs(audit): cold-start prompt for round 2 4-branch incremental audit
    Round 2 differs from round 1 in three ways:
    1. Closure regression spot-check: re-verify the 4 round 1 closure commits
    did not introduce regressions (Agent A — runs the same sim gates GPT
    ran in round 1 + verifies firmware byte-exact rebuild for the
    main-fpga-e203-alpha alpha smoke fix at 233db876).
    2. Five new audit angles that round 1 did not cover:
    - Annotated tag deref strict verification (Agent B — closes the FP-006
    gap that surfaced after round 1 when the tag wrapper SHA was
    mistaken for the peeled commit SHA)
    - arm-conv vs e203-conv cross-branch sync (Agent C — round 1 only did
    mai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
2026-05-03 fix(sys): add async-assert/sync-release reset + cim_done CDC sync
    Pre-tape-out CDC audit found two unsynchronized async signals being
    consumed directly by clk-domain logic in chip_top.sv:
    1. rst_n_pad (pad-level async reset) was passed directly to snn_soc_top.
    Every always_ff in the design used `posedge clk or negedge rst_n`, so
    the reset assertion is async (correct) but the release was also async.
    At deassertion the rising edge of rst_n_pad can violate flop
    recovery/removal timing relative to clk, which can drive flops into
    metastability and leave the post-reset state non-deterministic. This
    is a textbook ASIC pre-tape-out hazard.
    2. cim_done_ext (analog CIM completion s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
    [chip_top.sv, reset_sync.sv, reset_sync_tb.sv, sync_2ff.sv, sync_2ff_tb.sv]
2026-05-03 docs(audit): cold-start prompt for round 2.5 CDC + autonomous reverify
    Specialized round 2.5 prompt focused exclusively on the reset_sync +
    sync_2ff (cim_done CDC) changes that just landed across all 4 branches:
    main 49e78af4
    main-fpga-e203-alpha 90fa3480 (cherry-pick)
    feature/v2-arm-fpga-demo-conv bf56e942 (+ v2b_arm_demo_top)
    feature/v2-fpga-e203-conv 08e5b8f6 (+ snn_soc_v2b_e203_top)
    Differences vs round 1 / round 2:
    - Tightly scoped: only audit reset_sync + cim_done sync changes, not the
    whole project (rounds 1/2 were full-branch sweeps).
    - Authorizes fix-on-sight + autonomous board reverify in the prompt
    itself: GPT mus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
2026-05-03 docs(audit): merged round 2.5 prompt — full 4-branch + CDC focus + autonomous reverify
    User-requested merge of round 2 (full-dimension audit) and round 2.5
    (CDC + autonomous board reverify) into one prompt to be run as a single
    GPT-5.4 (effort=xhigh) cold-start session. Scope expansion is acceptable
    because the user has 770 KB context budget allocated.
    What this merged prompt covers (all in one session):
    1. ALL audit dimensions of round 2 (RTL bug hunt, Python ↔ RTL parity,
    firmware full-stack, 4-branch consistency, CIFAR plateau evidence,
    DCO compliance, sim regression sweep) — none dropped.
    2. CDC / reset domain DEEP audit with explicit focus on the just-landed
    reset_sync.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
2026-05-03 docs(audit): round 3 final closure prompt — verify round 2 fixes + commit + board reverify
    Round 2 GPT completed full-dimension audit (round 2 prompt run) and
    fix-on-sight on all 12 findings (F001 HIGH + 4 MEDIUM + 7 LOW), but the
    fixes are still in worktree dirty state across all 4 branches — never
    committed, never pushed. Round 3 picks up that tail.
    Round 3 scope (one GPT cold-start session):
    1. INDEPENDENT VERIFY of round 2 GPT's worktree changes against the
    12 finding descriptions — do not blindly trust the round 2 self-report.
    Read each modified file in worktree, confirm the fix actually
    implements the finding semantics (not partial / not breaking other
    things / not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
2026-05-03 docs(audit): round 3 prompt — augment CDC + cross-branch consistency + recursive next-round
    Two augmentations to the round 3 final closure prompt addressing user's
    review of coverage gaps:
    1. Agent H.2bis added — explicit cross-branch byte-level diff for the new
    reset_sync / sync_2ff infrastructure (rtl/sys/*.sv, tb/*.sv, sim/*.f,
    sim/run_*.sh) AND the chip_top.sv "── Async / CDC synchronizers"
    instantiation block. Previously H.2 only checked single-branch
    wiring correctness; now H.2bis catches the case where one branch
    silently drifted while the other three stayed in sync. Drift gets
    auto-synced and added to Agent F's commit queue.
    2. §11.bis added — recursive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
2026-05-03 docs(audit): round 3 prompt — method X full coverage (13 sub-agents)
    User selected method X over methods Y/Z (more agents, accept scope cost).
    Round 3 prompt now covers 16 of 18 audit dimensions in one GPT cold-start
    session, with the remaining 2 (tape-out PPA + vivado synth report) explicitly
    deferred to round 4 because they are structurally separate engineering
    tasks that would push session ETA beyond 20h.
    Coverage delta from previous round 3 version (8 agents → 13 agents):
    Agent I (NEW): Python ↔ RTL parity + manifest SHA verification
    - manifest internal consistency (per-bundle field sanity)
    - manifest ↔ doc/19 + conv_extension_log byte-exact match
    - cosim PASS mar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
2026-05-03 rtl/sim: fix reset-sync edge cases and host-path wrappers
    Includes H reset_sync/sync_2ff boundary fixes, JTAG rescue selftest sync, and Git-Bash/WSL repo-path wrapper fixes in main sim runners.
    Verified: RESET_SYNC_TB_PASS, SYNC_2FF_TB_PASS, LIGHT_SMOKETEST_PASS, WEIGHTED_SIM_PASS, JTAG_PYHOST_SELFTEST_PASS, E203_SMOKETEST_PASS.
    [e203_tb.sv, reset_sync.sv, reset_sync_tb.sv, sync_2ff.sv, sync_2ff_tb.sv]
2026-05-03 fw: harden main boot and app polling paths
    Includes round-2 fixes F002/F003/F007 plus bounded DMA/CIM waits in fw/main.c and rebuilt tracked boot_rom/silicon_bringup artifacts.
    Verified: E203_SMOKETEST_PASS, BOOT_ERASE_E2E_TB_PASS, CHIP_TOP_ROM_SMOKE_PASS, CHIP_TOP_ROM_HI_SMOKE_PASS.
    [boot_main.c, boot_rom_main.c, main.c, silicon_bringup.c, uart_printf.c]
2026-05-04 docs(audit): alpha round 4 reverify补单 prompt
    Round 3/4 收口审查发现 alpha 漏了 round 4 board reverify。其他 3 条支线
    （main / arm-conv / e203-conv）都补了 round 4 reverify evidence；alpha
    最近一次板验仍是 round 3 (uart_capture_20260503_round3_postfix_reverify.txt)。
    但 alpha 的 round 4 commits 包含真实 firmware/binary 变化：
    - 456b78c0: boot_rom.bin 1928 → 2336 字节 (+408 bytes 真代码)
    + boot_rom_main.c +11 行 + boot_main.c +12 行
    - cc9553aa: rtl/sys/reset_sync.sv +10 行 (含 STAGES=1 边界 + ifndef SYNTHESIS fatal)
    + rtl/sys/sync_2ff.sv +8 行 (含 WIDTH<1 fatal)
    - ef2a6f59: silicon_bringup.bin 3680 →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
2026-05-04 docs: paper handoff summary — 2026-05-04 closure single source of truth
    Final paper / 简历 / 答辩 / handoff 单点真相. After round 1/2/3/4 audit
    chain + alpha round 4 no-reburn rationale, all evidence-backed claims +
    source-of-truth file paths + 红线 are consolidated here.
    Structure:
    §1 Evidence-backed claims (按可信度排序)
    1.1 板验 byte-exact (4 dual-CPU board verify entries)
    1.2 训练精度 5 个 entry (Fashion 14×14 / MNIST 14×14 / LeNet MNIST /
    Fashion 28×28 FC / LeNet Fashion)
    1.3 T-sweep 2×3 矩阵 (T=30 universal sweet spot finding)
    1.4 量化栈天花板特征化 (MNIST 93-96% / Fashion 82-84% / CIFAR 13%)
    1.5 Pre-tape-ou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
2026-05-04 dc: adapt synthesis scripts for V1 chip_top tape-out area estimate
    Adapts the user-provided DC template (originally for fifo_512x10) to
    synthesize V1 main branch chip_top. Output: area / qor / timing reports
    + gate-level netlist for tape-out area estimation.
    Project-specific changes vs template:
    set_env.tcl:
    - working_design = chip_top (was fifo_512x10)
    - RTL_FILE = "." (DC runs from dc/, flist.f stays in dc/, RTL paths
    use ../rtl/* relative)
    - file_version = soc_v1_estimate
    - do_scan = 0 (first-pass area baseline; flip to 1 for DFT pass later)
    - lib_slow / lib_fast unchanged (same SMIC 55nm HS-RVT lib as template)
    constraint_sdc.tcl:
    - Single clock CLK = clk_pad @ 50 MHz / T = 20 ns /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
2026-05-04 dc: add area optimization flags + black-box stubs to fix over-estimates
    Adds 4 black-box stubs in dc/stubs/ (sram_simple, sram_simple_dp,
    boot_rom, cim_macro_blackbox) and a new dc/flist_blackbox.f that swaps
    them in. Adds 5 OPT_* flags in set_env.tcl to control:
    OPT_SRAM_BLACKBOX default 1 use stubs vs full RTL
    OPT_USE_TEMPLATE_MEM_LIB default 0 skip unused SNPU SRAM macros
    OPT_AREA_HIGH_EFFORT default 1 -area_high_effort_script
    OPT_GATE_CLOCK default 1 -gate_clock auto insertion
    OPT_POST_COMPILE_AREA default 1 optimize_netlist -area sweep
    dont_touch.tcl extended to protect SRAM/ROM stubs from optimization
    when OPT_SRAM_BLACKBOX=1 (constant-0 outputs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
    [boot_rom_stub.sv, cim_macro_blackbox_stub.sv, sram_simple_dp_stub.sv, sram_simple_stub.sv]
2026-05-04 fix(dc+rtl): harden dc synthesis flow and presto blockers
    [snn_soc_top.sv, sram_simple_stub.sv]
